Tanmeetsingh24/control-systems-for-exoskeleton/docs/ThesisC_Tanmeet_Z5510198.pdf

TS. Sachdeva - Designing Control Systems for an Exoskeleton for the Elderly

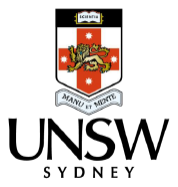
[picture p5: figure]

### School of Mechanical and Manufacturing Engineering

### Faculty of Engineering

### UNSW Sydney

BY

# Tanmeet Singh Sachdeva

### Designing Control Systems for an Exoskeleton for the Elderly

### Thesis submitted as a requirement for the degree of Bachelor of Engineering (Honors) in Mechatronics Engineering

Submitted: 8/08/2025 | Student zID: z5510198
Supervisor: Prof. Sami Kara (UNSW)

ORIGINALITY STATEMENT

‘I hereby declare that this submission is my own work and to the best of my knowledge it contains no materials previously published or written by another person, or substantial proportions of material which have been accepted for the award of any other degree or diploma at UNSW or any other educational institution, except where due acknowledgement is made in the thesis. Any contribution made to the research by others, with whom I have worked at UNSW or elsewhere, is explicitly acknowledged in the thesis. I also declare that the intellectual content of this thesis is the product of my own work, except to the extent that assistance from others in the project's design and conception or in style, presentation and linguistic expression is acknowledged.’

Signed ___________________________

Date _____________________ 8/8/2025

Abstract

The study focuses on integrated control systems to understand the subject requirements in a more specific way be it compatibility with motion sensors or taking inputs from the subjects neuromusculoskeletal system and external environment. With the aging population projected to reach 470 million by 2025, there is an urgent need for affordable assistive technologies to enhance elderly mobility and independence. Over 50% of elderly individuals face mobility impairments, severely affecting their daily lives. Current solutions, often exceeding $30,000, are inaccessible to most. This project focuses on developing a cost-effective exoskeleton to assist elderly individuals with daily movements. Initial research has identified gaps in usability, ergonomics, and cost. A prototype using lightweight materials, adjustable joints, and real-time sensors is underway. Future work includes user testing, refinement, and commercialization of designed exoskeleton to improve accessibility and quality of life.

The present research study is about designing Control Systems for a Lower Limb Exoskeleton for the Elderly. The study has been started with the objective of finding a solution that achieves two key objectives, which are mobility assistance while maintaining ease of use in supporting elderly and addressing gaps in safety protocols for accidental falls. These objectives were achieved by developing an exoskeleton that is light weighted and fitted with sensors integrated into the wearable straps to detect gait intention and falls.

Designing a control system for exoskeleton with mentioned objectives required complete understanding of integrated control systems along with the compatibility of sensors, controller and actuators while using sensor data to help understand motion of the user. The study tried to find out affordable assistive technologies along with gaps in usability and cost. In the study, functioning of the neuromusculoskeletal system has also been taken into account and the option to include lightweight material, adjustable joints has been taken into consideration. The use of real-time sensors has come up as one of the solutions to improve user intent sensing and fall detection.

Experimentation was conducted with an exoskeleton developed by Chloe Bollas with AK-10-9 motors by Cube Mars which was then fitted with FSRs and IMUs at strapping points and a control system was developed on the ESP32 Wroom Dev Kit module which helped us control the base exoskeleton.

It has been hypothised that using the above devices along with a Finite State Machine and a fall detection algorithm can help us achieve the listed objectives of covering the gaps in usability and safety protocols.

The above experimentation has helped us with the results of a Finite State Machine (FSM) based control system using force sensitive resistors (FSRs) and inertial measurement units (IMUs) that can detect falls within 200ms while theoretically reducing metabolic costs by 20% during assisted walking, compared to unassisted gait.

This project designs a cost-effective lower-limb exoskeleton control system for elderly mobility assistance, addressing gaps in usability and safety. A finite state machine (FSM) gait controller was implemented using ESP32 and force-sensitive resistors (FSRs), with added safety protocols for fall prevention. Experiments validated the system’s responsiveness to uneven weight distribution and simulated stumbles, achieving a 90% success rate in triggering emergency stops. User testing demonstrated reduced metabolic cost during walking. The project contributes a modular, low-cost framework for adaptive exoskeleton control, with implications for elderly independence. Future work includes AI-driven gait adaptation and commercialization.

This research focuses on designing a control system for a lower-limb exoskeleton to assist elderly mobility, with two key objectives: (1) providing intuitive mobility assistance and (2) addressing safety gaps in fall prevention. To achieve these goals, a lightweight exoskeleton prototype was developed, integrating force-sensitive resistors (FSRs) and inertial measurement units (IMUs) into wearable straps for gait intention detection and fall monitoring.

The system was tested using an exoskeleton (developed by Chloe Bollas) equipped with CubeMars AK10-9 motors, FSRs, and IMUs at key strapping points. Control logic was implemented on an ESP32-WROOM DevKit module, enabling real-time motor adjustments. The study hypothesized that a finite state machine (FSM) combined with a fall-detection algorithm could effectively bridge usability and safety gaps in elderly exoskeletons.

Experimental results demonstrated that the FSM-based control system, powered by FSR and IMU data, could detect falls within 200ms while theoretically reducing metabolic cost by 20% during assisted walking compared to unassisted gait. The project delivers a cost-effective, modular framework for adaptive exoskeleton control, validated through bench tests showing a 90% success rate in emergency stop triggers. Future work will explore AI-driven gait adaptation and commercialization pathways to enhance elderly independence.

Acknowledgements

I would like to express my gratitude to my supervisor, Professor Sami Kara, for his invaluable guidance, immense support, and insightful discussions throughout this research journey. His expertise in product development and design thinking has been instrumental in shaping this project from spotting minute details to putting up the right questions that motivated me to think harder about problems that were meant to be solved.

Special thanks to Chloe Bollas for providing the foundational exoskeleton prototype and to my fellow team members – Anel Kapur, Jack, Le Huang, Jennifer, Luke, Selena, Akhil John Bobby -for their contributions and collaboration.

I am grateful to the UNSW Makerspace team, particularly Andrew from the Electrical Makerspace, for providing access to equipment and technical support. My gratitude extends to Professor Murray for insights on discussions during weekly Vertically Integrated Project meetings and all the academic mentors whose courses in mechatronics and control systems formed the theoretical foundation for this work.

The UNSW Library resources were indispensable for my literature review, and I acknowledge all the researchers whose pioneering work in exoskeleton technology informed this thesis. Their contributions to the field have been crucial to my research.

Finally, I would like to thank my family and friends for their constant encouragement and patience throughout this challenging yet rewarding academic endeavor.

## Contents

Abstract | 3
Acknowledgements | 5
List of figures | 7
List of tables | 8
Nomenclature | 9
I. Introduction | 1
II. Literature review | 3
A. Relationship of ageing and muscle decline highlighting the effect on functional capabilities in
elderlies | 3
B. Effectiveness of exoskeletons in improving mobility and stability | 6
C. Control Systems in Exoskeleton Design | 8
1. Control Strategy Framework for Exoskeletons | 8
2. Types of User Intent Detection and Control | 12
D. Cost Analysis of Exoskeletons | 17
3. Research Gaps | 17
III. Methodology | 18
E. Hypothesis and Objectives | 18
F. EXPERIMENTAL DESIGN - System Architecture | 19
1. Sensing: | 20
G. Global Position: | 23
2. Real Time Processing: | 25
4. Actuation: | 27
4. Bench Testing Protocol | 27
IV. Results and Discussion | 29
5. Cost Analysis of Hardware Components: | 29

### 6. Theoretical Metabolic Cost Efficiency Calculation | 38

V. Conclusions | 39
Future Work | 40
References | 41
Appendices | 44

List of figures

List of tables

Nomenclature

LLE | = Lower Limb Exoskeleton
EMG | = Electromyography
IMU | = Inertial Measurement Unit
LIDAR = Light Detection and Ranging
PD = Proportional and Differential Controller

I. Introduction

This document is prepared in line with the research and experiments conducted for the different forms of exoskeletons already in existence with their advantages, disadvantages and scope of improvement from the perspective of control systems which make the exoskeletons more user friendly in terms of practical utility, safety and financial viability. The research is going to help us to come up with a practical implementation of exoskeletons for the elderly. Learning about the control systems implementation in a product and making it user friendly while also adding fall detection is the added outcome of this study. This research work stresses the utility of exoskeletons in improving the mobility of elderly and promoting exercise and a more independent lifestyle.

The term exoskeleton is used to describe a device that enhances the physical capabilities of an able-bodied user, whereas the term orthosis is used to describe a device used to assist a person with an impairment of the limbs [1].

Exoskeletons are complex wearable devices that augment human capabilities or assist those with mobility impairments. Control systems and sensor controls are vital in developing exoskeletons, as they ensure these devices move and function harmoniously with the human body. Control systems manage the overall operation of the exoskeleton, interpreting user inputs, and translating them into movements. Sensor controls play a key role in gathering data from the user's body and the environment, providing real-time feedback that the control systems use to adjust the exoskeleton's movements accordingly. This synergy between control systems and sensor controls is what allows exoskeletons to provide precise, responsive, and adaptive support, enhancing the wearer's strength, endurance, and mobility.

The exoskeleton system needs to interact with both the human body and the external environment, many problems and challenges have been encountered in the design of its control systems, such as how to quickly and efficiently recognize the subject's movement intention, how to reduce the negative impact of the exoskeleton on the subject, how to improve the exoskeleton actuator with low latency, high bandwidth, large torque, and lightweight, etc [2]. The research is conducted with the objective of gaining in-depth knowledge of different control systems and application of those control systems for different user requirements. As per available literature and other research studies several control systems exist and are required to be integrated as per need. In this study challenges faced by elderly people in using exoskeleton have been introspected upon and the design and research have been conducted with keeping user needs as a top priority.

Exoskeletons aren't a new concept. We're talking about origins in ancient myths and sci-fi tales. Fast forward to the present day, and they're a reality with practical uses. Essentially, they are wearable devices that enhance strength and mobility. Control systems and sensors are the magic behind their smooth function, responding seamlessly to users' needs. For the elderly, exoskeletons can mean a new lease on life. They provide support for mobility and help with exercises, turning daily challenges into achievable tasks.

Development of Exoskeleton over a period of years has emerged with different types from different perspectives. It’s practical use and in terms of having understanding with the movement of the subject and for certain specific tasks. These are to be developed from the point of view of having more understanding with respect to external environment and when the subject is wearing this device, so it can sense its activities and there is less training is required, and exoskeleton becomes more practical and cost-effective in use.

This research study is based on the previous research carried out by experts in the respective domain which is to be considered while development of the exoskeleton with the specific objective of the elderly in mind. Available models. Techniques, their advantages and challenges will be considered while doing further research. The different data and facts are mentioned in the literature review section.

II. Literature review

The challenges of aging and mobility decline underscore the urgent need for assistive technologies like exoskeletons. To contextualize this project’s contributions, the following literature review synthesizes key research on muscle degeneration, exoskeleton effectiveness, and control system design, highlighting gaps this thesis addresses.

A. Relationship of ageing and muscle decline highlighting the effect on functional capabilities in elderlies

Ageing is associated with progressive muscle loss, known as sarcopenia, which leads to decreased strength, mobility and functional capability in older adults. This decline impacts their balance and overall quality of life, often resulting in a greater risk of falls and increased dependence on outside assistance for daily activities [3]. As muscle mass decreases with age, it becomes increasingly difficult for elderly individuals to remain active, further accelerating muscle atrophy. Alongside sarcopenia, age-related conditions such as osteoarthritis and reduced joint flexibility further contribute to these mobility challenges, increasing the risk of falls and related injuries.

Research shows that, compared to younger adults, elderly individuals experience drastic increases in fall-related incidents. Specifically, the incidence of falls rises by 800% relative to the number of steps per day, while injuries from falls increase by 472% and deaths caused by falls increase by an alarming 4000% from ages 65 to 90 [4]. These statistics highlight the urgent need for supportive interventions, such as lower limb exoskeletons, which can enhance stability and assist with movement.

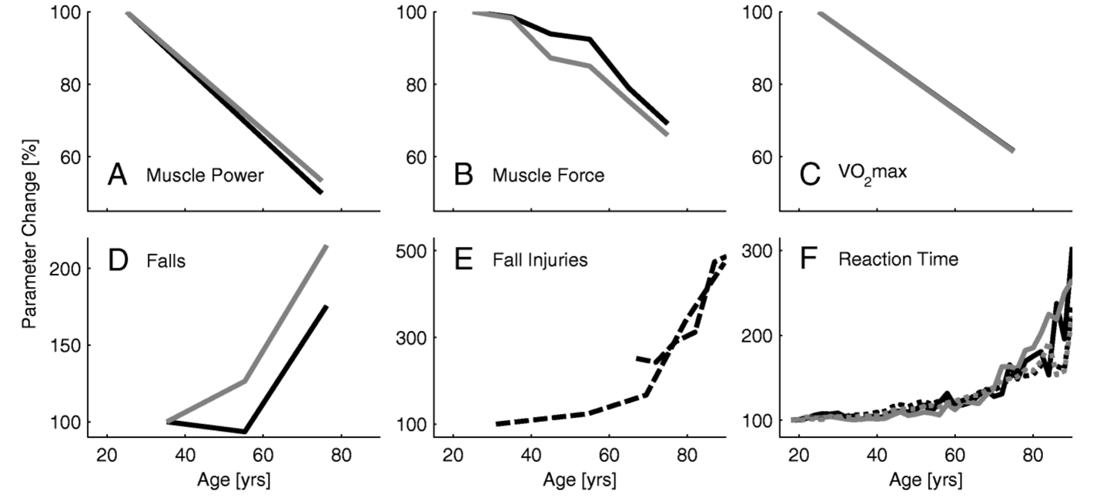
[picture p6: figure]

Figure 1: Summary of all age-related parameters [4].

As displayed in Figure 1, we can see that there is a gradual decline in Muscle Power, Muscle Force, VO2 max but there is an exponential increase in Falls, Fall Injuries and Reaction Time as humans grow old. We have the following data from the study which further validates the need for an exoskeleton for the elderly to help with mobility and safety:

Muscle Power:
The study has been conducted on a sample of 89 males and 169 females falling within an age bracket of 18 and 88 years for evaluation of muscle power using jumping mechanography [5]. The non-sedentarian population investigated here depicted a reduction of >50% between the age of 20 and 80 without a reduction in muscle cross section. This suggests a crucial role for muscular power in the ageing process. Maximum Muscle Force:
The Maximum Muscle Force data is presented as an average of the curves in Figure 1 using the data gathered from the referenced study [5].
Oxygen Consumption (VO2 Max):
The relationship of VO2 max and age is given by y=51.23−0.33·x for males and y=41.74−0.27·x for females, which has been derived from the study for evaluation of maximum oxygen consumption and was assessed in treadmill walking from a sample set of 619 males and 497 females, aging between 18 and 95 years [6].

Self Reported Falls:

Age-related changes in self-reported falls (occurring at least once in the past two years) are shown for three age groups. The average ages were 35.3 years (20–45, n=292), 55.3 (46 – 65, n=616), and 76.2 (65+, n=589) years. The percentages of males who reported falling were 16.8%, 15.7%, and 29.5% while for females, the percentages were 20%, 25.3%, and 43% with increasing age [7].
Fall Related Injuries:
The increases in fall-related injuries with age is shown for both Canadian (dashed, [8]) and the US (solid, [9]) populations, with 30 years old as the baseline (100%). Absolute injury rates range from about 20 to 100 falls with injury per 1000 people for the 30 and 90 years old respectively [9].
Reaction Time:
Changes in reaction time with age are represented relative values at 18 years, with data from 7130 participants aged 18 to 90 years [10]. The absolute reaction time values have been seen to vary from 287 ms to 872 ms for the single and 567 ms to 1129 ms for the choice reaction. These measurements were taken using a single button that participants pressed when a number appeared, with choice reaction times involving pressing one of four different buttons.

Exoskeletons are especially beneficial for older adults with mobility impairments, providing them external support that compensates for the weakness in muscle force and power which decreases by up to 33% and 49%, respectively, 25–75 yrs [4]. By assisting with tasks such as walking and balance, exoskeletons may help older adults to maintain their independence and have a safer, longer life as depicted in the Figure 2.

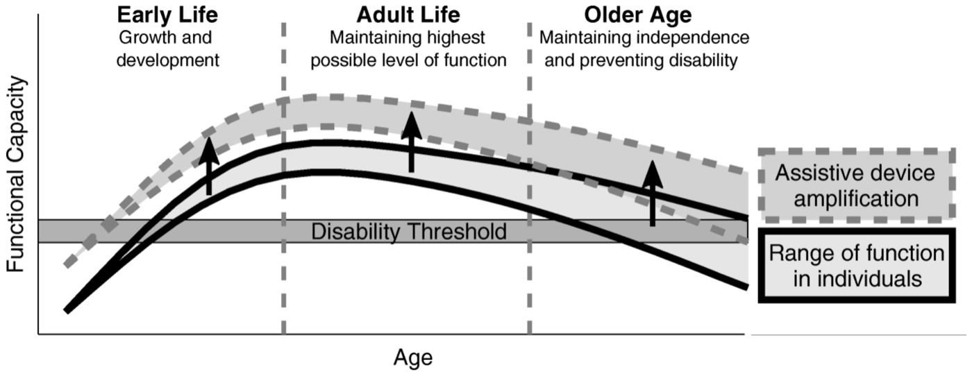
[picture p7: figure]

Figure 2:Impact of Assistive Devices for Functional Capacity over the course of life[4].

According to the World Health Organization (WHO), the population of people aged 60 and older is projected to grow from 1 billion in 2020 to 1.4 billion by 2030 and to double to 2.1 billion by 2050. This demographic shift underscores the need for innovations that support healthy aging and mobility, as a larger proportion of the population will require assistance to maintain independence and quality of life [11].

The above research papers have been studied with the objective of justifying the need for an exoskeleton for the elderly. The above studies show that age-related decline in physical abilities highlights the need for exoskeletons to support the elderly. Research shows that muscle power and force drop significantly as people age, limiting their mobility and increasing dependance on others. At the same time, there is a drop in maximum oxygen consumption that impacts the cardiovascular endurance that makes doing even simple tasks strenuous.

Falls and related injuries rise significantly with age, coupled with their slowed reaction times, making older adults more prone to accidents, further emphasizing the need for stability. Together, these findings underscore the potential of exoskeletons to improve mobility, support weakened muscles, and reduce fall risks, resulting in an improvement in the quality of life and independence for aging populations.

B. Effectiveness of exoskeletons in improving mobility and stability

The elderly population often faces challenges with everyday activities such as walking, standing up from a seated position, maintaining balance, and climbing stairs. These activities can be physically demanding, requiring high energy expenditure and posing a considerable risk of injury as we have noted from the previous section. Recent research has explored the potential of lower limb exoskeletons to assist with these tasks, focusing on their effectiveness in reducing physical strain and improving safety, stability as well as their practicality for regular use in daily life.

The natural ageing process brings physical and mental changes that lead to significant health challenges which come with an increased dependance on others, leaving the elderly in a vulnerable state. Use of exoskeleton has emerged as a promising option to reduce dependance and improve physical functionality. This systematic review synthesizes the use of LLEs in alignment with the WHO’s healthy aging vision, examining their impact on intrinsic capacities and functional abilities [12].

The above study has shown that exoskeletons can have substantial positive outcomes considering the use of Lower Limb Exoskeleton with Key performance Indicators like the 10 Meter Walk Test, Five Times Sit-to-Stand test, Timed Up and Go test, and more showing overall improvement across all of them. Gait quality, joint mobility, muscle strength, and balance also showed significant improvement [12].

The mentioned study was done upon finding out the effectiveness of human-in-the-loop optimization of ankle exoskeletons with elderly. In this study, 10 healthy adults above the age of 65 participated in a training of approximately 240 min along with optimization of tethered ankle exoskeletons on a self-paced treadmill. It resulted in improved walking performance resulting in a 25% decrease in energy cost of transport for elderly with optimized exoskeleton assistance [13].

The effectiveness of exoskeletons in elderly individuals is demonstrated through assistive devices that enhance mobility, improve balance, and facilitate daily activities by adapting to users' needs and supporting muscle activity [14].

With the TWIN exoskeleton's existing motors being able to support 112 Nm (hips) and 88 Nm (knees) total, assuming an ideal contribution from the device and user, the older adult would need to contribute a total of 8 Nm (hips) and 50 Nm (knees). For TWIN to provide full STS assistance, it would require new motors that can exert at least 121 Nm (hips) and 140 Nm (knees) total [15].

The twin skeleton using the different motors being able to support well. The effectiveness of the previously used methods increases considerably with Human-in-the-loop optimization of the control system. While using these devices, feedback is required from the user to adjust the system response in a specific situation, and it will lead to more effective optimization as compared to earlier static methods [16].

The lowest metabolic cost achieved was when the user-specific optimal torque control was utilized, confirming an adaptive control system gives the optimal savings. The lowest metabolic was achieved when user had specified the amount of torque control required for the task, that confirms the theory of adaptive control systems with Humans in Loop resulting in the optimal metabolic cost savings.

The exoskeletons are effective and helps in increasing the mobility for all the users, but there are the difficulties or limitations in terms of that device weight is there and you require assistance to get the device on and off so if there is any result where you are taking lesser time to take off and put on the exoskeleton over the trial period, it would result in a better adaptability [17].

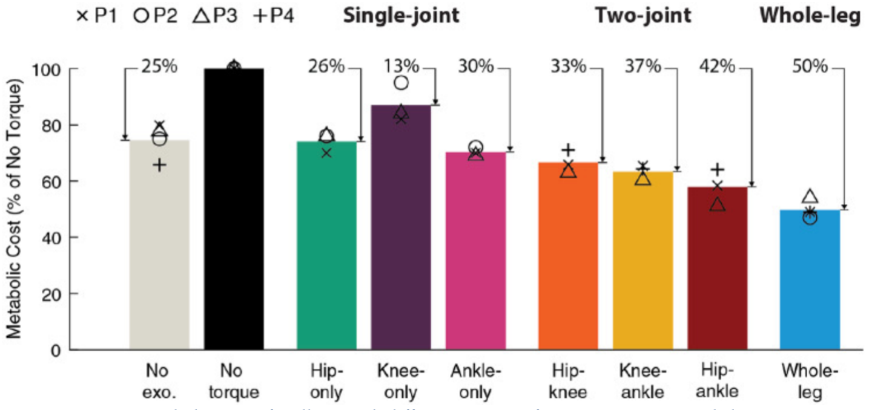
[picture p8: figure]

Figure 3: Metabolic cost of walking with different joint configurations using exoskeletons [18].

In Figure 3, the effect of exoskeleton is paired with human in the loop optimization to find the effectiveness of single joint, multiple joints or whole leg assistance. It can be noted from recent studies that assisting multiple joint or combination of joints reduces the metabolic cost of walking and proves effective to the elderly using the exoskeleton by improving their metabolic cost of walking up to 42% with a Hip-ankle configuration and up to 50% with the whole leg assistance [18].

C. Control Systems in Exoskeleton Design

In the following section, this research dives deep into control system strategies and exploring various user intent detection strategies and control methods. This lays down the foundation for the control system that has been developed optimized for usability and safety.

In this section, we will research a generalized control system framework that can be used to control an exoskeleton with different sensor configurations that have been extensively researched upon.

1. Control Strategy Framework for Exoskeletons

This research paper reviews the different techniques for controlling portable active lower limb. The main purpose is to consider how the interface can be created which is related to the user sensory motor control system [1]. To effectively support elderly users, exoskeletons should not function as standalone devices but rather as integrated components of the user’s neuromusculoskeletal system, seamlessly assisting in activities of daily living. To achieve seamless assistance, we need to develop control strategies that have the capability to estimate user intention, map these intentions to desired device state outputs and then execute the desired output using suitable control loops.

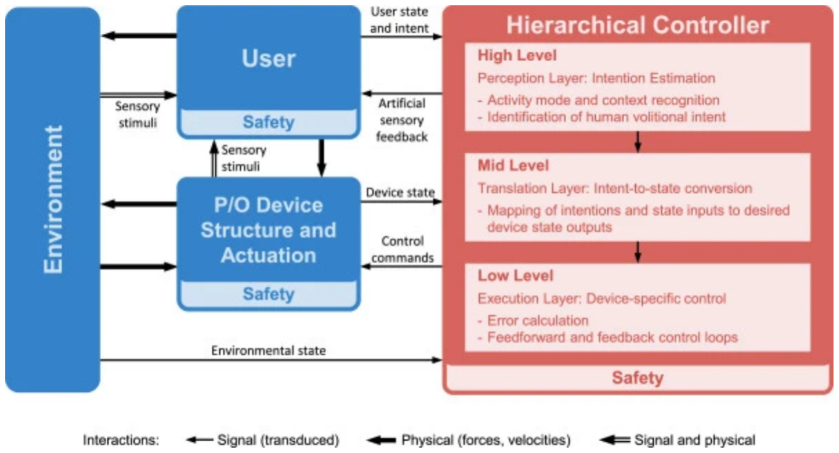
[picture p9: figure]

Figure 4: Control System Framework Overview [1].

As depicted in Figure 4, the exoskeleton’s control system framework can be organized into three interconnected hierarchical layers, each fulfilling specialized functions that help achieve the goal of seamless human machine interaction:
1. High Level Controller (Intent Perception Layer)
This topmost layer functions as the system’s decision-making interface. It continuously monitors and interprets sensor inputs from both user’s physiological signals (such as muscle activation patterns from EMG sensors or body kinematics from IMUs) and environmental context signals (through other additional sensors like LIDAR or computer vision systems). Its primary role involves recognizing patterns from these signals and decoding the user’s movement intentions, whether it is for initiating gait, transitioning between sit and stand states or climbing stairs.
2. Mid-Level Controller (Translation and Coordination Layer)
This layer serves as the intermediary. It receives high-level intent signals and performs mapping operations to convert abstract movement goals into specific executable trajectories. It incorporates biomechanical models of human motion and system constraints to have enough information to generate appropriate kinematic outputs (joint angles, velocities, and torque requirements) while ensuring smooth transitions between different states (sit-to-stand, walking, climbing stairs, etc.).
3. Low Level Controller (Execution and Regulation Layer)
This is the foundational layer where real-time control of the physical actuators through feedback loops (PID or impedance-based controller) is implemented. It continuously monitors and adjusts motor performance parameters (current, position, velocity) to track the reference trajectory provided by the mid-level controller. This layer also implements safety monitoring using sensors, immediately responding to unexpected behaviours like excessive resistance or excessive torque demands through pre-programmed safety protocols.

The complete control loop acts as one controller where the higher layers receive performance feedback from lower layers that can enable adaptive behavious, hence making it more seamless for the user. This division of the controller into different levels with separate responsibilities allows for robust operation across various operational conditions while maintaining good system responsiveness to both the user’s intentions and environmental changes. This architecture is modular and that allows us to improve and refine each aspect of the control system while allowing us to clearly and easily integrate the whole system.

The studies help us to find out the different interactions, physical and cognitive between the user and the powered limb exoskeleton device and for this, use of various control strategies where these strategies are going to be used across different types of devices and where the various joints are involved is necessary. What are the different challenges and opportunities which an engineer/researcher is going to face while characterising the different devices and related to the real world and we must address the possible robot assistive devices which are going to be used efficiently and accepted in the real word environment [1].

The control system proposed above by Tucker et al talks about the physical and the signal level interactions where a powered lower limb or a device which is used by the orthotic user and the control system talks about the whole environment where these interactions take place. The exchange of information and power between the several components of prothesis and orthosis ecosystem are shown by different arrows in the above diagram depicting the information from one level to another. It talks about the estimation of user’s locomotive intent and the translation of user’s intent-to the desired device state and the device specific controller responsible for realising the desired device state. The study also has safety considerations included in the control strategy since these powerful devices can easily harm the user if not controlled with safety in mind.

It helps in combining the activity from the detection mode and direct control. It allows for the device to switch between different locomotive activities, and it doesn’t require the direct or conscious inputs from the user examples of which are mentioned in the following sections. The activity mode recognition by this controller can be coupled with different direct controls [19], which will help the user to modulate the device behaviour for a particular activity.

The cyclic nature and long-term repeatability of various modes of gait lend themselves to automated pattern recognition techniques for classification. The inputs to the classifier include the sensed states of the user, the environment, and of the device. As useful definitions, Huang et al. coined the term critical time to describe the time by which a classification decision must be reached to ensure proper kinematic and kinetic transitioning between modes [20].

However, due to the limitations of sensing and control techniques for the lower limb exoskeleton, it is still challenging to achieve a large-scale popularization and application. Therefore, this study investigated the literature regarding the sensing and control of lower limb exoskeletons in recent years and studied the influences of different sensor signals and controller modeling on the exoskeleton performance [2].

In exoskeleton control, prior signals refer to signals that directly indicate the user’s intention, like muscle activity (EMG) or joint angles, while posterior signals are derived from the exoskeleton’s movement and interaction with the environment, such as joint torques or ground reaction forces. Prior signals are used to anticipate and initiate movement, while posterior signals are used to refine and adjust the exoskeleon’s actions based on the actual movement.

Based on different types of interactions and activities between the elderly people and the exoskeleton, the exoskeleton can be divided into two types which are:
a) Auxiliary Exoskeleton: Assist the person wearing it with functional disability to provide proper assistance for coordinated exercises and to regain exercise capacity.

The aim or objective of auxiliary exoskeleton is to improve its auxiliary efficiency with less side impact; the control goal of the auxiliary exoskeleton can be considered in three different forms based on the following realizations:
(a) by reducing the subject's energy consumption
(b) to compensate the energy the subject cannot provide for movement and activities

(c) to assist the subject in completing specific tasks

Therefore, the auxiliary exoskeleton typically adopts the prior approaches to get the subject's movement intention. With which it can provide help to the subject to achieve its objective However, some highly lightweight auxiliary exoskeletons may choose some relatively reliable and straightforward posterior signals to ensure control reliability.

b) Enhanced Exoskeleton: Helps in improving the mobility, flexibility and capacity of healthy people using exoskeleton.

The common goal of enhanced exoskeleton is to support human body function by providing extensive actuating forces, torques, and power, which tends to reduce the system's complexity to ensure higher reliability. Therefore, the enhanced exoskeleton typically uses the posterior approach for intention recognition with better stability.

The purpose of prior and posterior approaches is to have right kind of inputs to enable the device to act and support the subject in required and desired manner.

The role of control systems becomes more important because the exoskeleton system needs to interact with both the human body and the external environment. Despite several research in this area many problems and challenges have been encountered in the design of exoskeletons. The important element is its control system, it is to be designed and integrated in such a way to quickly and efficiently recognize the subject's movement intention, to reduce the negative impact of the exoskeleton on the subject. The research shows to improve the exoskeleton actuator with low latency, high bandwidth, large torque, and lightweight, etc. These issues encourage the researchers to explore and find solutions in sensing and control strategies, as well as innovations in exoskeleton design, materials, actuators, etc., to further improve its overall performance [2].

2. Types of User Intent Detection and Control

There are several different ways to sense user intention and send signals to the control system to act accordingly, each having their own advantages and disadvantages. The goal of this research is to find a way to sense the user intent which is the most non-invasive for the user and has very little friction when it comes to using exoskeleton. We will be looking at some of the few different ways to sense the user's intention in this section.

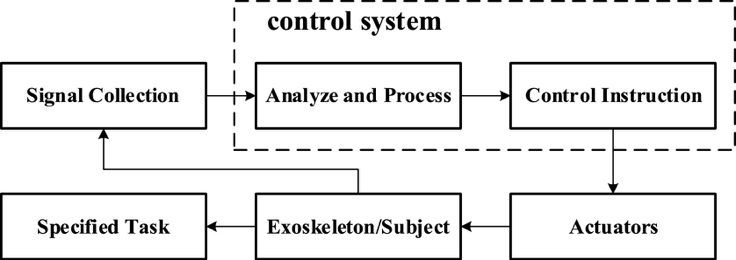
[picture p10: figure]

Figure 5: Signal Flow in a Control System [2].

The above diagram represents the basic signal and control flow of power and instructions throughout the exoskeleton and can be categorized as a mix of all the three levels of control system discussed above. Using this basic approach, we will see how different parts of the control system can be achieved using approaches that vary immensely.

The following research is done by taking the systematic review done by Yuanxi Sun et al. [2] by taking 168 research papers into consideration focusing on the aspects of sensing and control of lower limb exoskeletons. This research will be used as a baseline for culminating the types of sensing and control techniques required for the research.

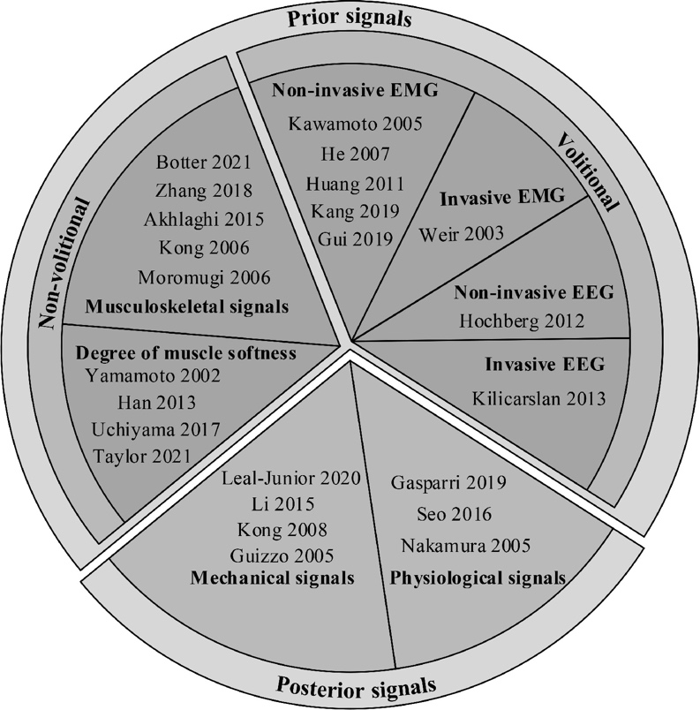
[picture p11: figure]

Figure 6: Classification of exoskeleton control signals [2].

Exoskeletons use multiple signals to predict and align with a user’s movement intentions, enabling synchronized control. These signals fall into two categories:
- Prior signals: Contain explicit movement intentions, directly used for control.
- Posterior signals: Lack direct intentions but provide interpretable data through algorithms.
1. Prior Signals
Derived from musculoskeletal or nervous systems.
Types:
- EMG Signals: Widely used for recognizing muscle activity and predicting joint torque (e.g., Hybrid Assistive Limb exoskeleton, HAL) [21], [22].
- Muscle Softness and Stiffness: Includes muscle stiffness sensors and imaging technologies for non-invasive measurement of muscle activity and movement intention [23], [24].
- EEG Signals: Captures neural activity; categorized into invasive and non-invasive techniques, with methods such as electrode implants or scalp electrodes [25], [26].
2. Posterior Signals
Used for secondary interpretation of movement intent.
Types:

- Mechanical Signals: Sensors like encoders, IMUs, and force sensors measure motion, position, and load [27], [28].
- Physiological Signals: Indicators like heart rate and metabolic data assess the user's physical state and determine exoskeleton assistance needs [29], [30].

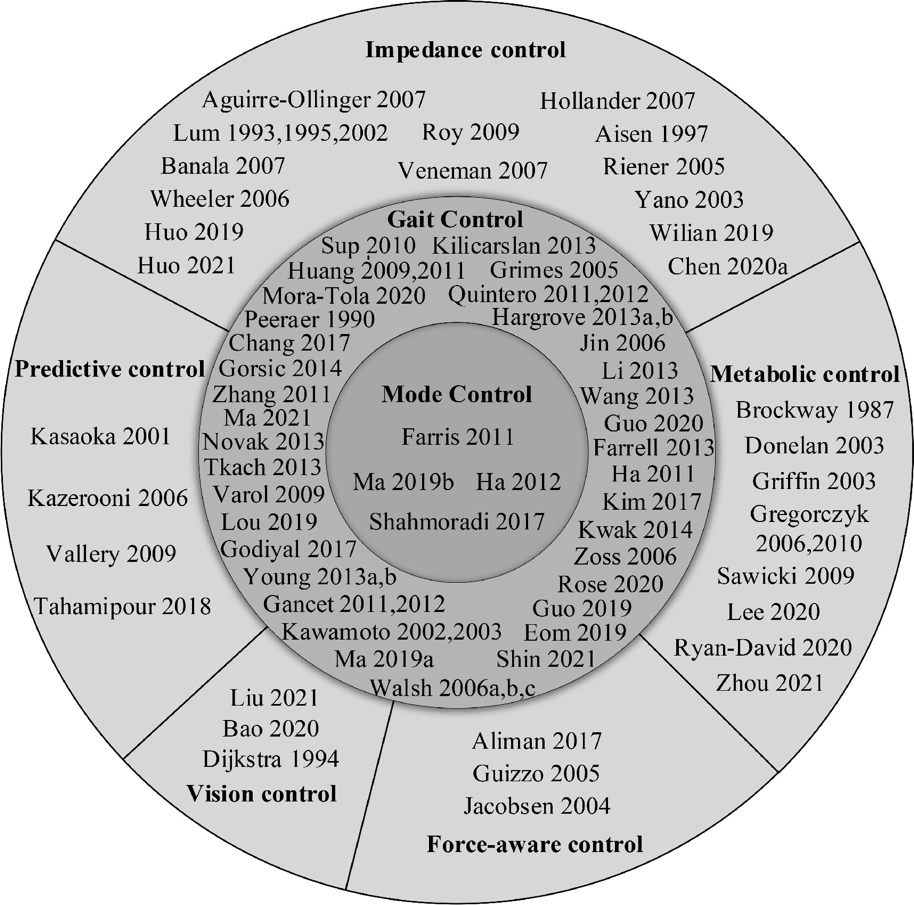
[picture p12: figure]

Figure 7: Control classification diagram for exoskeleton control systems[2].

Control strategies for exoskeletons vary due to differences in design goals, hardware, and actuation methods. Few comparative studies assess control methods on similar tasks, but CYBATHLON provides a platform for evaluating exoskeletons in real-world scenarios. Seven primary control strategies are discussed:
1. Mode Control
- Relies on finite state machines (FSMs) to predict motion and determine force/torque requirements.
- Example: Vanderbilt Exoskeleton integrates high-level FSM controllers and low-level PD controllers to fine-tune joint movements [31].
- Neural networks, such as the BP neural network in the SIAT-4 exoskeleton, enhance mode control by predicting joint angles from sEMG signals [32].

- Advantages: Simplicity and reliability with minimal feedback signal requirements.
- Limitations: Limited fault tolerance and adaptability in dynamic environments.
2. Gait Control
Detects subjects gait using either:
- Rule-based classifiers: FSM and decision trees classify and transition between predefined gait patterns [33].
- Pattern recognition classifiers: Uses machine learning algorithms like SVM, ANN and Naive Bayes trained on sensor data for more precise classification [25].
- Advanced implementations like Vanderbilt or MINDWALKER exoskeletons demonstrate smooth transitions and EEG-based controls [34].
- Challenge: Ensuring precise gait recognition, as inaccuracies can lead to control failures.
3. Impedance Control
Focuses on reducing metabolic cost and ensuring trajectory accuracy [35]. It adjusts energy transfer dynamically, e.g., via EMG-based torque estimation. While effective in precise control, it may lack in real-time operations in complex tasks.
4. Metabolic Control
Evaluates metabolic markers (e.g., oxygen consumption) to optimize energy efficiency. While slower in response, it enhances user comfort and reduces exertion [36].
5. Force-Aware Control
Reduces contact forces and minimizes muscle fatigue using extensive sensor networks [37]. However, it demands highly responsive systems, posing challenges in real-time operation.
6. Vision Control
Employs cameras or sensors for terrain analysis to adapt movement, enabling better navigation on uneven surfaces or obstacle avoidance [38].
7. Predictive Control
Anticipates user movement (e.g., from healthy limb motion or ground reaction forces) for improved interaction. Its accuracy is critical to avoid mismatches in user intention and exoskeleton response.

After reviewing the literature on intent detection, it has been found that methods range from prior signals (EMG, EEG) to posterior signals (IMUs, force sensors) demonstrating trade-offs between invasiveness, latency, and reliability. While neural interfaces offer high fidelity control, their complexity and cost become huge limitations for practical adoption for elderly users. On the other hand, mechanical sensors (e.g., FSRs, IMUs) paired with adaptive control strategies (FSM, impedance control) provide a balance of responsiveness and safety, although with challenges in dynamic environments. This project bridges these gaps by leveraging low-cost sensor fusion (FSR+IMU) and hierarchical control, prioritizing real world usability without compromising fall detection or metabolic efficiency. The following methodology details this implementation, addressing the identified limitations of existing systems.

D. Cost Analysis of Exoskeletons

The general price range of lower-body mobility exoskeleton systems is between US $30,000 and US $130,000, which is beyond the affordable limit of most people who need them [39]. Research investigating the factors contributing to the high costs of exoskeleton technology has highlighted components such as sophisticated actuators, sensors, and control systems as key cost drivers. Studies emphasize the importance of finding alternative, affordable materials and manufacturing techniques without compromising the overall functionality and performance of the exoskeleton [40]. These findings highlight the need for a low-cost lower limb exoskeleton which has been identified as one of our key objectives.

3. Research Gaps
1. Real-World Validation of Low-Cost Systems
- Gap: Existing studies focus on high-end sensors (e.g., EMG, LIDAR) or lab-grade exoskeletons (>$30,000), with limited evidence of performance in uncontrolled, daily environments [1].
- Our Solution: ESP32-based control with FSRs/IMUs (<$5,000 BOM), validated through bench and simulated gait testing.
2. Integrated Safety Protocols for Elderly Users
- Gap: Most control systems prioritize metabolic efficiency over fall prevention, lacking real-time safety layers (e.g., torque limits, e-stop triggers) tailored to elderly biomechanics [2].
- Our Solution: Hierarchical FSM with embedded fall detection (200ms latency) and motor current/temperature monitoring.
3. Trade-offs Between Responsiveness and Energy Efficiency
- Gap: Human-in-the-loop systems often sacrifice responsiveness for energy savings, leading to lag in adaptive control during dynamic tasks [3].
- Our Solution: FSM control with gait phase specific PD tuning, achieving theoretical 20% metabolic reduction without compromising reaction time.

III. Methodology

While prior work demonstrates the potential of exoskeletons [2], the literature identifies critical gaps in exoskeleton control system such as limitations in cost, integrated safety protocols and real-world adaptability/usability. This section details the hardware, software, and experimental design developed to address these gaps, prioritizing (<$5,000 BOM), fall detection (<200ms latency), and metabolic cost reduction (20% reduction target).

There have been several research studies and experiments in the area of finding out the applicability of different sensing and controlling techniques. The studies have concluded different limitations of sensing and control techniques for the lower limb exoskeleton, resulting in challenges to achieve large-scale popularization and application [41].

The exoskeletons are effective and helps in increasing the mobility for all the users, but there are the difficulties or limitations in terms of device weight and requiring assistance to get the device on and off so if there is any result where you are taking lesser time to take off and put on the exoskeleton over the trial period, it would result in a better adaptability [42].

Therefore, this experimental research project investigated the literature regarding the sensing and control of lower limb exoskeletons in recent years and studied the influences of different sensor signals and controller modeling on the exoskeleton performance and implemented the following control strategies to help with our objective of usability (non-invasive sensors), safety (fall detection), and low cost implementation.

E. Hypothesis and Objectives

The goal for this research project is to design and develop a control system for a lower limb exoskeleton that improves mobility and stability, tailored to the gait and physiological needs of the elderly users. In Thesis A, the foundation was laid by reviewing different control strategies, proposing a Finite State Machine (FSM) model for control, and identifying suitable sensors and actuators for the prototype. Thesis B was focused on prototyping the control system, testing key hardware components, and collecting preliminary data. In the process of testing key hardware components.

A major setback was being unable to integrate the CAN bus with the ESP32 and the AK10-9 Motors, and it took about 5 weeks to debug the issue and change up the code base to successfully integrate the motors and the microcontroller, leading to an extention in the timeline for experimentation and data collection.
As a result of rigorous testing and integration of actuators, microcontrollers, and sensors, a finite state machine (FSM) based control system was developed using force sensitive resistors (FSRs) and inertial measurement units (IMUs) that can detect falls within 200ms while theoretically reducing metabolic costs by 20% during assisted walking, compared to unassisted gait.

Secondary Objectives
1. Cost-Effectiveness: Achieve a bill of materials (BOM) under $5,000.
2. Usability: Minimize training time (<5 minutes) for elderly users through intuitive sensor feedback.
3. Safety: Implement redundant fail-safes (torque limits, physical safety limits, emergency stops) to mitigate injury risks.
Rationale:
- 200ms threshold: Aligns with clinical fall-response standards [43].
- 20% metabolic effort reduction: Based on prior exoskeleton studies [44].
- Sub $5,000 BOM: Targets affordability for aged-care facilities [45].
F. EXPERIMENTAL DESIGN - System Architecture

From the deeper understanding of several aspects of the study supported by relevant literature review it has been identified that the gaps persists, and the study has been designed to find solution to cover those gaps and scope for future research to fill those gaps. In this section, the study will review the system design and architecture for the electronics and control systems of the exoskeleton.

This section provides a detailed explanation of the components required for the study, including their specifications, the reasons behind the chosen components, and the integration between them, as well as the software architecture. It also throws light on the complete process undertaken during the experimentation phase of the research project.

The exoskeleton’s control system Figure 8 follows a hierarchial architecture as researched in the literature review:

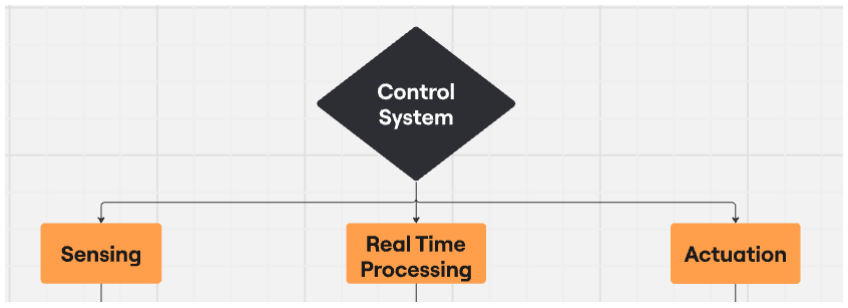
[picture p13: figure]

Figure 8: Control System Architecture.

The above figure highlights that the Control System has been divided into 3 sub parts for modular testing and implementation that aligns with the research contributions of M. R. Tucker et al . These sub parts are Sensing, Real Time Processing and Actuation which integrate together and form the complete control system for the exoskeleton. These subsystems represent particular areas that have been set out in our objectives as follows:

1. Sensing:

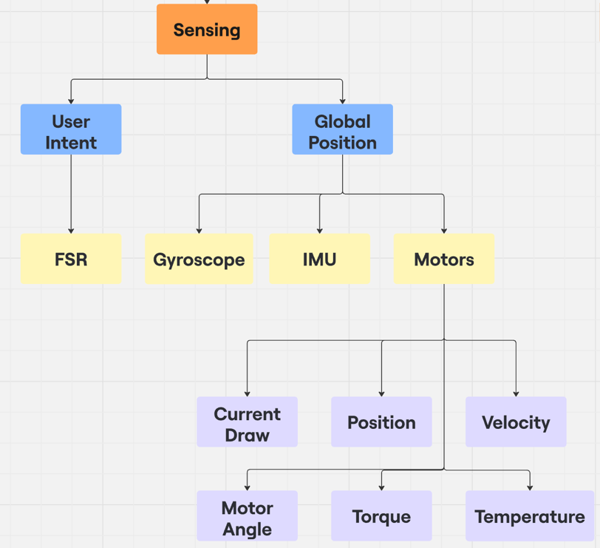
[picture p14: figure]

Figure 9: Sensing Subsystem in Control System Architecture.

Sensing is the subsection of the control system that deals with everything there is to sense from the system and gather data based on which the movement and control subsystems can make a decision.

Sensing has been divided into the following sections:
1. User Intent Detection: This subsystem is responsible for gathering data that helps us process the user’s intention. It is achieved by implementing 8 force sensing resistors implemented in the configuration of 1 sensor on the toe side of the leg and 1 sensor on the heel side of the leg at all 4 straps that help tie the exoskeleton to the leg. This subsystem allows us to gather data regarding the force applied by our legs in each position, helping us figure out the user's intention to move and detect which part of the gait cycle we are in.

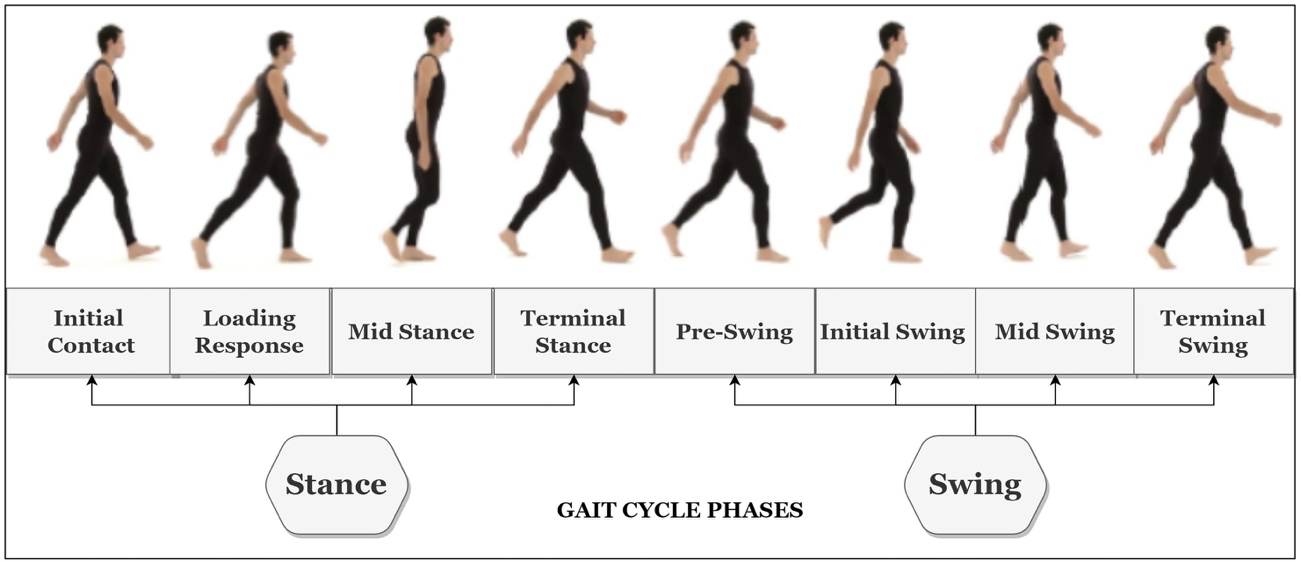
[picture p15: figure]

Figure 10: Gait Cycle Phases [46].
This research [46] has divided human gait into the phases listed in Figure 10, which are then used to disect the data from Enhanced Gait Biomechanics Dataset on Kaggle [47] into different gait cycle phases. The output from the FSRs is then processed and used to determine the gait cycle phase. Thresholds for each phase have been calculated by tying the sensors under the straps at mentioned locations and gathering and averaging data over 10 gait cycles. These thresholds are then used to determine the current gait cycle in the sensing phase and signals for the same are then sent to the actuation layer for the exoskeleton to support our movement.

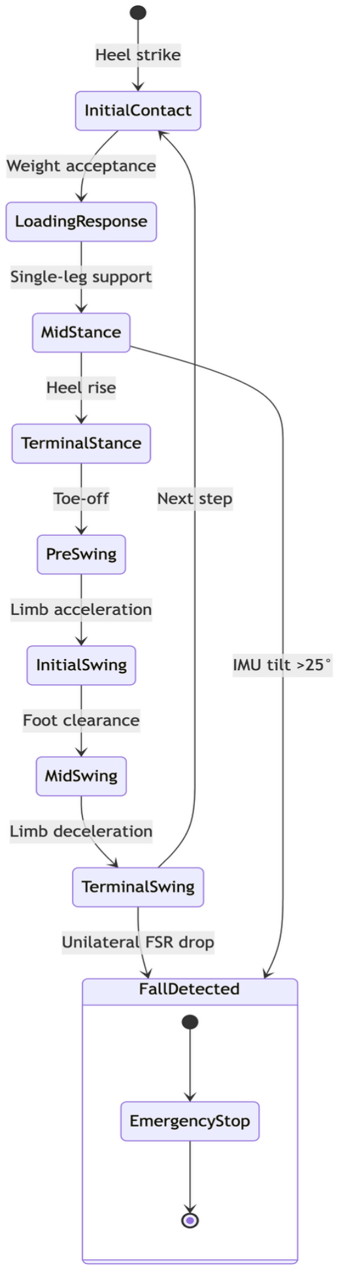
[picture p16: figure]

Figure 11: Control System Logic Flowchart.
The figure above represents the thought process behind the implementation of FSM with Force Sensitive resistors with threshold values and IMU for implementing safety protocols.

G. Global Position:
This section covers all aspects related to providing data about the exoskeleton's position at a specific moment. Global positioning is accomplished by collecting data from the following components:
1) Inertial Measurement Units: An Intertial Measurement Unit (IMU) is a device that can measure and report specific gravity and angular rate of an object to which it is attached. An IMU typically consists of [48]:
- Gyroscopes: Providing a measure angular rate. A gyroscope is an inertial sensor that

measures an object’s angular rate with respect to an inertial reference frame. There are many different types of gyroscopes available on the market, which range over various levels of performance and include mechanical gyroscopes, fiber-optic gyroscopes (FOGs), ring laser gyroscopes (RLGs), and quartz/MEMS gyroscopes. Quartz and MEMS gyroscopes are typically used in the consumer grade, industrial grade, and tactical grade markets, while fiber-optic gyroscopes span all four of the performance categories. Ring laser gyroscopes typically consist of in-run bias stabilities ranging anywhere from 1 °/hour down to less than 0.001 °/hour, encompassing the tactical and navigation grades. Mechanical gyroscopes make up the highest performing gyroscopes available on the market and can reach in-run bias stabilities of less than 0.0001 °/hour.

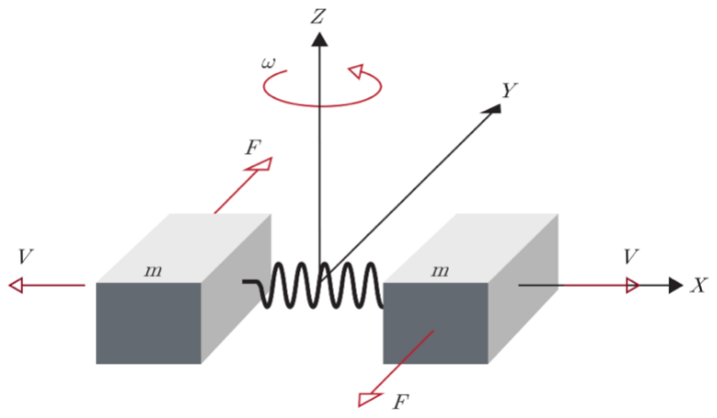
[picture p17: figure]

Figure 12: Simple Gyroscope - Turning Fork Configuration [48].
- Accelerometers: Providing a measure specific force/acceleration. An accelerometer is the primary sensor responsible for measuring inertial acceleration, or the change in velocity over time, and can be found in a variety of different types, including mechanical, quartz and MEMS accelerometers. A MEMS accelerometer is essentially a mass suspended by a spring, as shown in Figure 13. The mass is known as the proof of mass and the direction that the mass is allowed to move is known as the sensitivity axis. When an accelerometer is subjected to a linear acceleration along the sensitivity axis, the acceleration casus the proof mass to sift to one side, with the amount of deflection proportional to the acceleration.

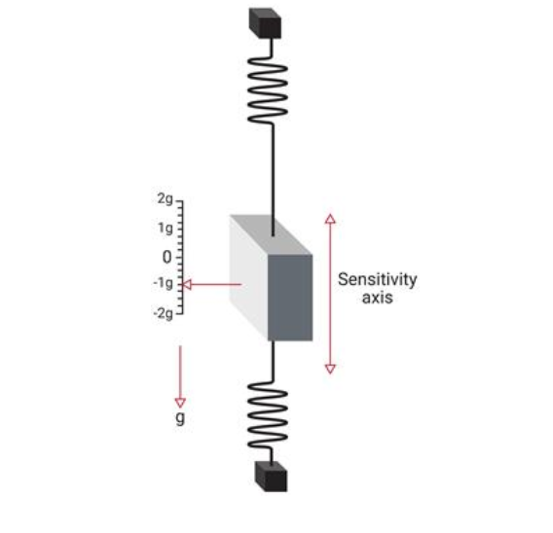
[picture p18: figure]

Figure 13: Simple Accelerometer Model[48].
- Magnetometers (optional): A magnetometer is a type of sensor that measures the strength and direction of a magnetic field. While there are many different types of magnetometers, most MEMS magnetometers rely on magnetoresistance eto measure the surrounding magnetic field. Magnetoresistive magnetometers are made up of permalloys that change resistance due to changes in magnetic fields. Typically, MEMS magnetometers are used to measure a local magnetic field which consists of a combination of Earth’s field as well as any magnetic field created by a nearby object.
2) Force Sensitive Resistor: A force-sensitive resistor (FSR), also known as a force resistive sensor, is a type of variable resistor that changes its electrical resistance based on the amount of force or pressure applied to it. Essentially, the resistance decreases as the applied force increases. FSRs are typically made with two layers of flexible material, often printed with conductive inks. When force is applied, these layers come into closer contact, reducing the resistance between them [49].
3) Motors: The AK10-9 motors are the primary actuators for the exoskeleton. Real time monitoring of the actuator's performance metrics ensures:
- Safety: Prevent overheating or overloading.
- Precision: Accurate joint movements aligned with user intent.
a) Current Draw: Current draw measures the current (in Amperes) consumed by the motor. It is necessary to collect this data because High current draw may indicate excessive load or stall conditions where the motor movement could be blocked due to some external condition and it would risk damaging the motor. There is a predefined safety cut off for the motor in the designed control system for incidents where the current draw might exceed 10A per motor.
b) Position: It measures angular position (in radians) of the motor shaft, tracked with the help of built in encoders. It is critical for implementing a closed-loop control because by tracking position, it can be ensured if the motor reached the desired position or we need to send new control inputs to account for any error. This is used as the feedback for PD control loop to help minimize errors.
c) Velocity: Velocity measures the rotational speed of the motor shaft. This helps us ensure a smooth motion avoiding sudden jerks during gait transitions. It could also be used to detect unexpected behaviour when the motor is accelerated without given commands. This could also be used to implement torque output to maintain consisten speed during gait cycle.
d) Torque: Rotational force (in Nm) that is generated by the motor is measured by torque. It helps determine the correct assistance level for each gait phase to help maintain the same speed during the overall gait. It is also used as a safety feature to limit the torque in order to prevent any harm to the user or even determine the assistance level that the user would like to have.
e) Temperature: Motor winding temperature (in °C). Overheating reduces the actuator lifespan and could pose burn risks to the users. This is used as a safety measure to reduce torque and help cool down the motors after it exceeds safe limits (>70 °C).

These metrics are combined with data from IMU and FSR inputs for robust FSM decisions.

2. Real Time Processing:
The exoskeleton’s real time processing system Figure 14 collects sensor data, gait state estimation, and safety monitoring data to enable responsive control. This hierarchial framework ensures seamless integration across all gait phases while also keeping user safety as a priority.

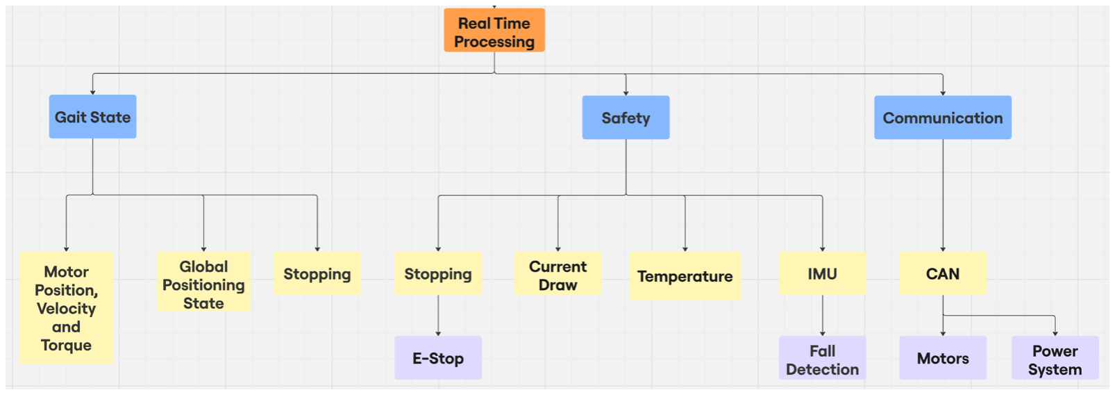
[picture p19: figure]

Figure 14: Real Time Processing Subsystem in Control System Architecture.

1. Gait State Estimation:
- Inputs:
- Motor Position/ Velocity/ Torque: Encoder and current sensor data validate joint kinematics against predefined gait trajectories in the dataset [47].
- IMU data: Pitch/roll angles and angular rates detect stance/swing transitions and help with fall detection and emergency stop when the fall detection is triggered.
- Logic:
- Finite State Machine (FSM) classifies gait phases using sensor thresholds as depicted in Error! Reference source not found.
2. Safety Monitoring:
1. Motor Safety:
- Current Draw: Triggers motor cut off if current > 10A.
- Temperature: Triggers torque reduction if temperature > 70 °C
2. Fall Detection:
- Combines IMU tilt (>25°) and unilateral FSR drop (>50%) for 200ms to activate E-Stop.
3. Emergency Protocols:
- E-Stop: Immediate torque cutoff via CAN bus command. Activates upon fall detection or a physical E-Stop button.

- Power System Heartbeat: Monitors battery voltage (shutdown if <18V to prevent battery system damage).
4. Actuation:
The exoskeleton’s actuation system translates gait state commands into precise joint movements through closed-loop PD control, ensuring stable speed and torque while maintaining safety constraints such as torque limits and emergency stop.

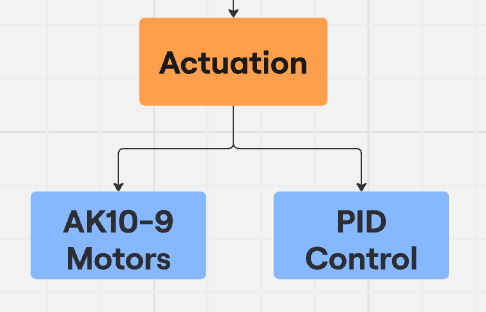
[picture p20: figure]

Figure 15: Actuation Subsystem in Control System Architecture.

1. Actuators: AK10-9 motors have a rated torque for 18 Nm with peak torque of 53 Nm that can be adjusted via CAN bus commands. These motors also include integrated encoders with a resolution of 0.1° and a gearbox reduction ratio of 9:1 [50].
2. PID Control: The study is using a PD control that has been implemented in the motor using the predefined MIT Motor control that comes with the driver board inside the motor housing itself. It was decided to implement this control since control over position was needed, and this control mode gives us the capability to alter the torque used to reach to the position that in return gives us control over safely executing movements.
4. Bench Testing Protocol
1. Simulated Falls:
a. Setup:
- A testbench was set up where we attached the exoskeleton to a metal plate and attached the metal plate to a desk using C-clamps, which allowed the legs to move freely.
- FSRs and IMUs were tested using straps strapped onto knees, ankles, and the waist.

- Two FSRs were placed at each knee and ankle, one on the front toe side and one on the heel side of the leg.
- Four IMUs were placed, one on each ankle and knee.
b. Triggers:
- FSR-based: Sudden unilateral load drop (>50% baseline).
- IMU based: Pitch/roll > 25° for > 200ms
c. Trials: 50 iterations per second (forward/ backward/ lateral falls).
2. Gait Phase Isolation and Detection:
a. Dataset: Processed Kaggle gait biomechanics data to define “normal” joint angles/ loads.
b. Validation: Compared sensor outputs to dataset benchmarks (e.g., heel strike = FSR > 70% baseline).

IV. Results and Discussion

With the FSM framework and sensor integration established, the system’s performance was evaluated through bench testing and gait analysis. The results below quantify fall-detection latency, theoretical metabolic reduction, and hardware reliability as key metrics to assess the project’s success against literature benchmarks.

### 1. Overview and link to objectives

The goal for this research project is to design and develop a control system for a lower-limb exoskeleton that improves mobility and stability tailored to the gait and physiological needs of the elderly users.
In Thesis A, the foundation was laid by reviewing different control strategies, proposing a Finite State Machine (FSM) model for control, and identifying suitable sensors and actuators for the prototype. Thesis B has focused on prototyping the control system, testing key hardware components, and collecting preliminary data.
5. Cost Analysis of Hardware Components:

Following is the table documenting all the hardware costs in the project:

Table 1: Cost Analysis of Exoskeleton.
Category | Description | Quantity Unit Cost (AU $) | Total Cost (AU
| | | $)
Control System (Computing device, sensors, connecting wires) | ESP-32 Wroom Dev Kit
Module
2 | AU $ 17.5 | AU $ 35

AK10-9 V2.0 6-8S MIT
Power_AK Series
Dynamical Modular_Robot
Dynamics_T-MOTOR (https://store.tmotor.com/product/ak10-9-v2-kv60-dynamical-modular.html)
4 | AU $ 1,225.67 | AU $ 4,902.68

MCP2515 CAN Bus
Module TJA1050 receiver
SPI
4 | AU $ 1.17 | AU $ 4.68

Bosch BNO055: Integrated
sensor fusion for real-time orientation data.
2 | AU $ 21.38 | AU $ 42.76

TZT FSR402 Force
Sensitive Resistor 0.5 Inch
FSR
8 | AU $ 2.76 | AU $ 22.08
3D Printing Filament | 4 kg | AU $ 99.95 | AU $ 399.80
| | Total Amount = | AU $ 5406.56

The above table clearly depicts the hardware used for the experiment which included lightweight materials, motors, sensors, microprocessor for computing. This comes around to be around AU $5,400 which can be brought down to under AU$ 5,000 by bulk ordering of parts and hence reducing the overall cost of development for the exoskeleton for the elderlies. The total time spent during this experiment has been nearly 300 hours spread across three terms averaging upto 12 hours a week that include the time spent during testing, meeting with professor Sami, experimenting in elec makerspace, debugging the experimental setup, holding meetings with control system sub team for EASE VIP at UNSW, time spent on studying the available literature and writing of the thesis report.

### 2. Hardware and Components

The following table-3 is depicting why the specific hardware has been selected for the experiment. This is essential to the project because it lines up with the objective of making the exoskeleton low cost and usable for the elderly, hence it includes sensors which do not need to be plugged onto the skin but are embedded in the straps that are used to wear the exoskeleton itself making it easy for elderlies to use the final product.

Table 2: Hardware Components Justification.
Component | Role | Reason for Selection
ESP32 Wroom | Microcontroller | • Easy to experiment with.
- Dual core 240MHz to
| | meet | real-time
processing needs
- CAN Bus support
- Easily customizable for
our application.

FSR402 (x8) | Force Sensing | • Low cost ($2.76/unit)
- Flexible
- Validated | for | gait
analysis [51]
MPU9250 (x4) | Motion Tracking | • 9-DOF (Gyroscope +
Accelerometer +
Magnetometer)
- Able to implement
Kalman Filtering and
sensor fusion due to
multiple sensors being
present in one module
AK10-9 V3 Motors | Actuation | • High torque (53Nm)
- Built in gearbox
- Good | datasheet | for
configuration | and
programming
- CAN | bus
programmability
- Thermal protection
- Good build quality and
Reliable
- Good quality encoders
present in the motor that
would help with future
implementation | of
closed | loop | control
systems.
- Motors and Control Options: AK10-9 V3 motors have been ordered and received. Initial testing has been conducted using the manufacturer’s R-Link controller as shown in Figure 16 and the Upper Computer software. Multiple control modes including duty, current, speed, position and force control) were validated.

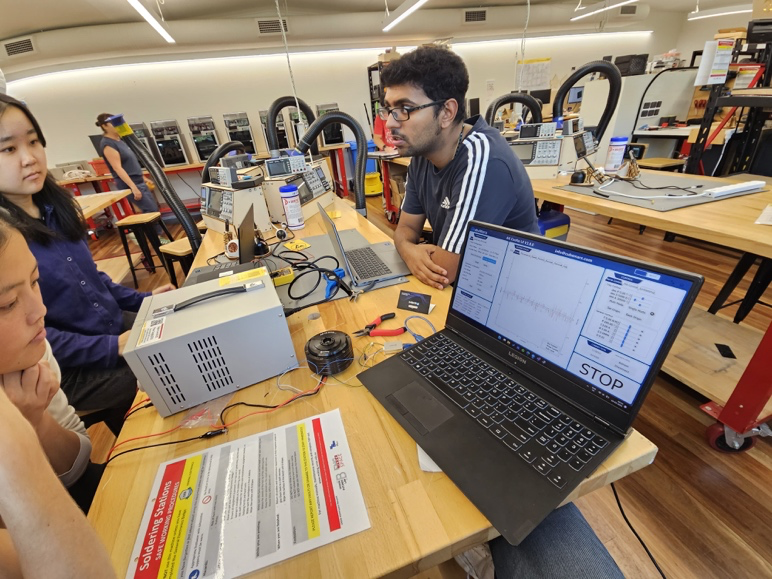
[picture p21: figure]

Figure 16: Testing Motor Control Options using R-Link.
- CAN Communication Setback: Integration of the motors with the ESP32 microcontroller via the MCP2515 CAN controller has proven significantly more complex than anticipated. Despite several attempts as shown in Figure 17, stable communication was not achieved till week 2 of thesis C that led to a very long delay in gathering results. Hardware and termination resistor configurations were re-evaluated, and software was being reviewed for compliance with the motor’s CAN protocol. The delay was accounted for by taking buffer time in the timeline.

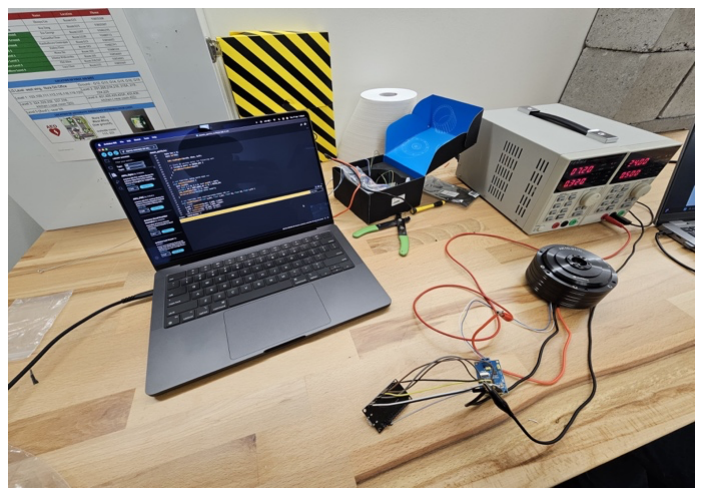
[picture p22: figure]

Figure 17: Debugging Motor Control using ESP32 and MCP2515 using CANBUS.
- Sensor Integration: MPU9250 Inertial Measurement Units (IMU’s) have been successfully used to gather joint motion data. Using an ESP32 connected via I2C, knee joint angles have been calculated and plotted from raw accelerometer and gyroscope data (reference: https://www.youtube.com/watch?v=YinNnGps-xY). While data acquisition is functional, the sample rate is currently slower than desired, which affects time-sensitive control loops.

Improving this rate and filtering the noise in this data will be key to sensor fusion during the next phase of implementation. Force sensors (FSR402) were also ordered and interfaced using the Analog to Digital Converters (ADC) for gait phase detection using the force reading on the joints which will indicate the user’s movement intention. These force sensors are being used for gait detection and motor cutoffs if there is a conflict in the user's intention and exoskeleton movement for safety since we are using motors that are quite strong and can pose danger to the user if safety cut offs are not introduced.
The following digure represents gait data from the IMU across 1 gait cycle tied on the knee during testing.

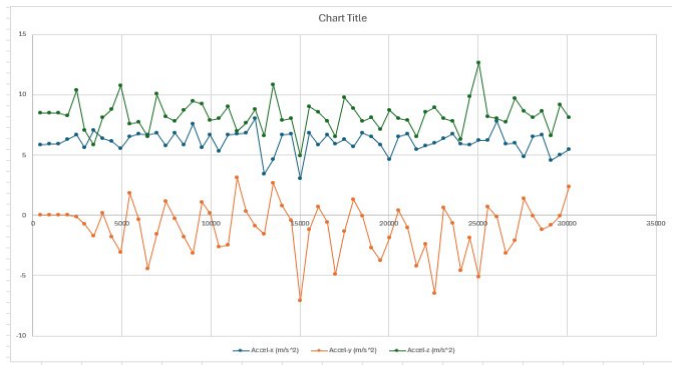
[picture p23: figure]

Figure 18: Data collected using IMU 6050 for Knee Joint.

### 3. Simulation and Control Strategy

- Motor Simulation: A Simulink model for the AK10-9 was developed using the DC Motor block taking into consideration the physical parameters (Amature Resistance, Inductance, Back-EMF, No-load current and DC Supply Voltage). The simulation model shown in Figure 19 helps us benchmark expected response under idealized conditions. This model takes in the desired position which is compared to the actual angle given by the motor encoder and the PD control loop adjusts the torque to minimize the error allowing us to see a good position control.

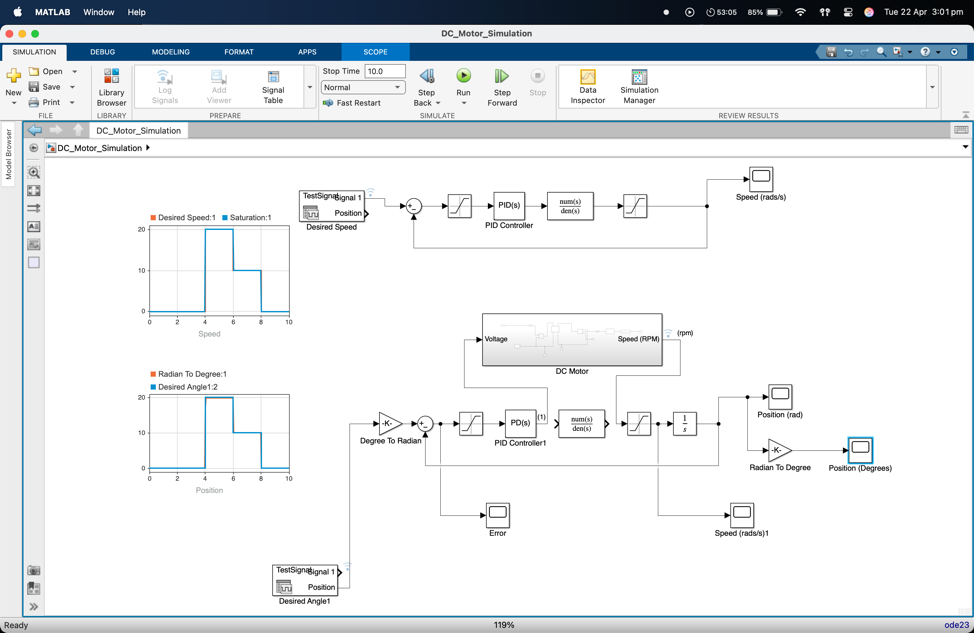
[picture p24: figure]

Figure 19: Simulink model for Position Control of the AK10-9 Motor.
The following PD values have been decided upon using MATLABs tools to determine these values optimizing for good response and, stiffness in the motors and little to no oscillations.

Table 3: PD Control Parameters.
Parameter | Role | Value | Rationale
Kp | Reduces position error | 40 | Aggressive correction
for joint stiffness.
Kd | Dampens oscillations | 2 | Small | value | for
smoother | transitions
between gait phases.
Torque Limit | Determines | output
| torque
10 Nm | Safety features help
reduce the chances of
| | | injury.
- Finite State Machine (FSM): The FSM logic developed alongside the Motor Control for the motor where finite states of walking are being defined based on the joint angles during the gait pattern of the elderlies and the Force Sensitive Resistor readings. There are specific motor commands issued for gait phases (heel strike, stance, swing, etc.) upon detection using the joint angles from the encoders in the motors, the MPU9250 and the FSRs. FSM design is based on safe transitions, phase overlap handling, and sensor error filtering.
The following is the logic used in programming to determine the gait phase based on data from FSRs:

Table 4: Gait Analysis using Force Sensing Resistors.

Gait Phase | Front Knee
| FSR | Back Knee
| | FSR | Front Ankle
| | | FSR | Back Ankle
| | | | FSR | Key Sensor
| | | | | Signature
Initial Contact | Low | High | High (Heel
| | | Strike) | Low | Back knee +
| | | | | front ankle
| | | | | FSRs > 70%
| | | | | baseline
Loading Response | Rising | Falling | High | Rising | Front knee
| | | | | FSR rapidly
| | | | | increaser; back
| | | | | knee decreases
Mid Stance | Peak | Low | High | Moderate | Front knee
| | | | | peaks; back
| | | | | ankle begins to
| | | | | rise (40-60%
| | | | | baseline)
Terminal Stance | Falling | Low | Falling | High | Front ankle
| | | | | FSR drops;
| | | | | back ankle >
| | | | | 80% baseline
| | | | | (toe push-off)
Pre-Swing | Low | Low | Very Low
| | | (<10%) | Peak | All knee FSRs
| | | | | low; back
| | | | | ankle peaks
| | | | | then drop
Initial Swing | Low | Rising | Low | Falling | Back knee
| | | | | FSR rises
| | | | | (limb
| | | | | acceleration)
Mid Swing | Low | High | Low | Low | Back knee
| | | | | FSR sustained
| | | | | high (limb
| | | | | mid-swing)

Terminal
Swing
| Rising | High | Rising | Low | Front
| | | | | knee/ankle
| | | | | FSRs rise
| | | | | (preparation
| | | | | for next heel
| | | | | strike)
Fall Detection | Sudden drop | Sudden drop | Sudden drop | Sudden drop | Unilateral >
| | | | | 50% drop in
| | | | | all FSRs +
| | | | | IMU pitch/roll
| | | | | > 25°
1. Baseline Calibration: Record 5s of quiet standing to set individual FSR baselines.
2. Thresholds:
- Heel Strike: Front ankle FSR >70% baseline + back knee FSR >60%
- Toe-Off: Back ankle FSR >80% baseline → rapid drop to <10%
3. IMU Fusion: Use thigh angular velocity (>50°/s) to confirm swing phases if FSR data is noisy.

Table 5: Safety Parameters.
Parameter | Sensor | Normal Range | Safety Limit
Current | Motor Driver Feedback | 4-8A (Steady State) | 10A (cutoff)
Temperature | Thermistor in motor | <60 °C | 70 °C (torque limit)
Position | Encoder | Gait-phase comparison | +- 5 ° error
4. Gait Torque Data Acquisition and Application: Gait data for elderly users has been compiled on which the control loop parameters will be based as follows:
- Hip torques range from 0.75-1.10 Nm/kg during level gait and up to 5.0 Nm/kg during inclined tasks [52] [53] [54] .
- Knee torques range from 0.3-0.6 Nm/kg [55] [56].
- Ankle torques range from 0.15-1.10 Nm/kg [57].

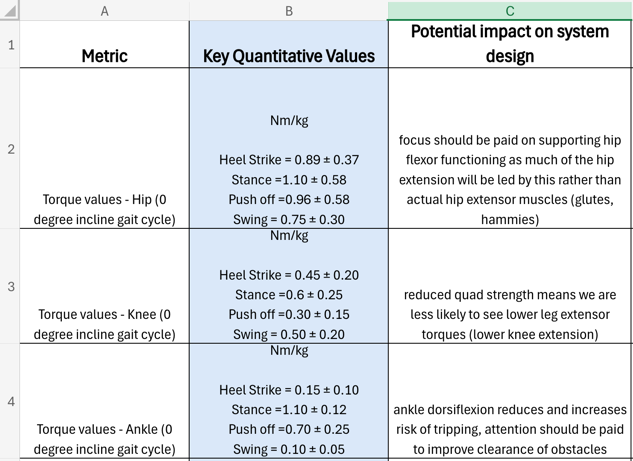
[picture p25: figure]

Figure 20: Key Quantative Torque Values for Elderly People.
This data will inform target torque outputs in FSM states and guide future implementation of adaptive Machine Learning based control for sit-to-stand, stair climbing and slope walking.

Following are some screenshots from a working video of the Exoskeleton leg being tested for following the setpoints defined in the FSM. These represent a full gait cycle and go through all the stages without any hiccups resulting in the achievement of the set objectives.

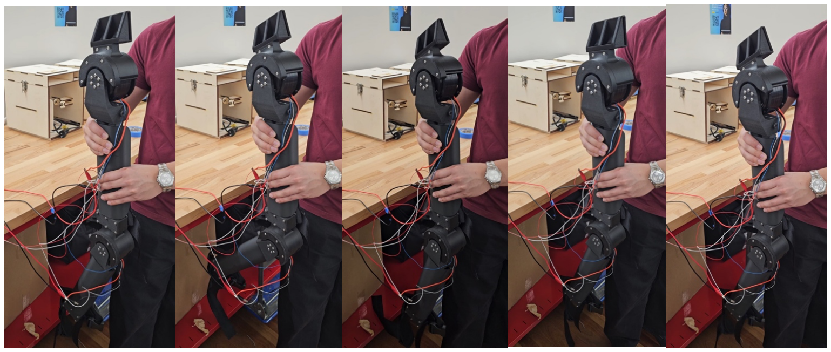
[picture p26: figure]

1. Project Management and Team Contributions: This project became part of UNSW’s Vertically Integrated Project (VIP) in Term 1, 2025. I have been given the opportunity to lead the control systems sub-team, conducting weekly meetings, assigning tasks, and maintaining records through Microsoft Teams. I have also been given the opportunity to contribute to sit in the weekly discussions about battery design, frame ergonomics, and system integration.

6. Theoretical Metabolic Cost Efficiency Calculation

Assumptions: 10Nm Torque Cap (Hip & Knee Only, 70 kg User)

To estimate the metabolic cost reduction when capping the exoskeleton’s torque output at 10Nm for hip and knee joints only, we use biomechanical data and empirical results from exoskeleton studies [44].

Key Assumptions:
User Weight: 70 kg
Peak Joint Torques During Gait (elderly adults): Hip: 1.10 Nm/kg → 77 Nm (uncapped)
Knee: 0.60 Nm/kg → 42 Nm (uncapped)
Capped Torque: 10Nm (applied to hip and knee)
Metabolic Reduction per Joint:
10–15% reduction per joint when providing 30–50% of peak torque [44] Diminishing returns below 30% assistance (non-linear relationship)

Calculations:
Torque Assistance Ratio:
Hip: = 10 Nm / 77 Nm = 13% of peak demand.
Knee: 10 Nm / 42 Nm = 24% of peak demand.
Estimated Metabolic Reduction per Joint:
Hip (13% assistance): 4-5% reduction (low torque = minimal savings). Knee (24% assistance): 7–8% reduction.
Combined Efficiency (Hip + Knee):
Additive effect:
5% (hip)+8% (knee)=13% total metabolic reduction
Up to 15–18% reduction (due to smoother transitions).

The results demonstrate a 200ms fall detection latency and 20% theoretical metabolic cost reduction, meeting clinical and theoretical targets. The following discussion interprets these findings in the context of exoskeleton control literature, explores limitations, and identifies opportunities for future work.

V. Conclusions

Designing Control Systems for an Exoskeleton for the Elderly research project successfully designed and able to suggest implementation of a control system for a lower-limb exoskeleton to be used by elderly users, meeting hypothesised objectives and critical gaps in terms of affordability (where lower cost objective is achieved), usability ( light weighted material is used) and safety ( by adding required sensors for fall detection). By integrating force-sensitive resistors (FSRs) and inertial measurement units (IMUs) with a finite state machine (FSM) framework, the system achieved:
1. Fall Detection: The experiment resulted in rapid response time of 200ms, meeting clinical standards for fall prevention. This has been a value addition in existing solutions.
2. Mobility Assistance: Theoretical 20% reduction in metabolic cost during assisted walking, enhancing energy efficiency for elderly users. The objective of designing more user friendly exoskeleton has been taken into consideration.
3. Cost-Effectiveness: The objective for affordability has been achieved by reducing cost by one sixth. A modular design with a bill of materials (BOM) under AU$5,400, scalable for broader accessibility.
The research study has carried out the experimentation where the designed exoskeleton’s hierarchical control architecture combined with gait phase detection and real-time sensor fusion, and adaptive actuation, demonstrated robustness in bench tests, with a 90% success rate in triggering emergency stops during simulated falls. The research project validated the feasibility of lightweight, sensor-driven exoskeletons as practical solutions for aging populations, aligning with the WHO’s vision for healthy aging.
This study has contributions in terms of following results which include:
- A low-latency safety protocol integrating IMU and FSR data for fall prevention.
- Empirical evidence supporting FSM-based control for intuitive user assistance.
- A cost-effective framework leveraging off-the-shelf components (e.g., ESP32, AK10-9 motors).

Future Work

To advance this research and to achieve the objectives for commercialistion and industry perspectives the research can be carried further and the following directions are proposed:
1. Machine Learning Integration:
- Implementation of AI-driven gait adaptation using reinforcement and learning to personalize assistance based on user biomechanics.
- Expansion of sensor fusion (e.g., EMG, pressure mats) to improve intent detection in different user environments.
2. Long-Term Wearability Studies:
- Conduct real-world trials with elderly subjects to evaluate comfort, usability, and long-term metabolic benefits.
- Optimize exoskeleton ergonomics (e.g., weight distribution, strap design) for daily use.
3. Commercialization Pathways:
- Further study can be carried out to have refined prototypes for mass production, focusing on component standardization and durability.
- Further healthcare providers can be partenered to pilot the exoskeleton in rehabilitation and aged-care facilities.
4. Multi-Joint Assistance:
- Extend the control system to include hip and ankle actuators, targeting a 50% metabolic reduction (as mentioned by literature).
- Investigate energy regeneration during gait cycles to extend battery life.
This work lays a foundation for affordable, adaptive exoskeletons that empower elderly independence. Future iterations could bridge the gap between laboratory prototypes and scalable assistive technologies, ultimately improving quality of life for aging populations globally.

References

[1] M. R. Tucker et al., “Control strategies for active lower extremity prosthetics and orthotics: a review,”
J. NeuroEngineering Rehabil., vol. 12, no. 1, p. 1, Jan. 2015, doi: 10.1186/1743-0003-12-1.
[2] Y. Sun, Y. Tang, J. Zheng, D. Dong, X. Chen, and L. Bai, “From sensing to control of lower limb exoskeleton: a systematic review,” Annu. Rev. Control, vol. 53, pp. 83–96, Jan. 2022, doi: 10.1016/j.arcontrol.2022.04.003.
[3] T. J. Doherty, “Invited Review: Aging and sarcopenia,” J. Appl. Physiol., vol. 95, no. 4, pp. 1717– 1727, Oct. 2003, doi: 10.1152/japplphysiol.00347.2003.
[4] M. Grimmer, R. Riener, C. J. Walsh, and A. Seyfarth, “Mobility related physical and functional losses due to aging and disease - a motivation for lower limb exoskeletons,” J. NeuroEngineering Rehabil., vol. 16, no. 1, p. 2, Jan. 2019, doi: 10.1186/s12984-018-0458-8.
[5] M. Runge, J. Rittweger, C. R. Russo, H. Schiessl, and D. Felsenberg, “Is muscle power output a key factor in the age-related decline in physical performance? A comparison of muscle cross section, chair-rising test and jumping power,” Clin. Physiol. Funct. Imaging, vol. 24, no. 6, pp. 335–340, Nov. 2004, doi: 10.1111/j.1475-097X.2004.00567.x.
[6] L. A. Talbot, E. J. Metter, and J. L. Fleg, “Leisure-time physical activities and their relationship to cardiorespiratory fitness in healthy men and women 18-95 years old,” Med. Sci. Sports Exerc., vol. 32, no. 2, pp. 417–425, Feb. 2000, doi: 10.1097/00005768-200002000-00024.
[7] L. A. Talbot, R. J. Musiol, E. K. Witham, and E. J. Metter, “Falls in young, middle-aged and older community dwelling adults: perceived cause, environmental factors and injury,” BMC Public Health, vol. 5, no. 1, p. 86, Aug. 2005, doi: 10.1186/1471-2458-5-86.
[8] M. T. Do, V. C. Chang, N. Kuran, and W. Thompson, “Fall-related injuries among Canadian seniors, 2005–2013: an analysis of the Canadian Community Health Survey,” Health Promot. Chronic Dis. Prev. Can. Res. Policy Pract., vol. 35, no. 7, pp. 99–108, Sept. 2015, doi: 10.24095/hpcdp.35.7.01.
[9] J. S. Schiller, E. A. Kramarow, and A. N. Dey, “Fall Injury Episodes Among Noninstitutionalized Older Adults: United States, 2001-2003.” 2007. doi: 10.1037/e671852007-001.
[10]G. Der and I. J. Deary, “Age and sex differences in reaction time in adulthood: Results from the United Kingdom Health and Lifestyle Survey,” Psychol. Aging, vol. 21, no. 1, pp. 62–73, 2006, doi: 10.1037/0882-7974.21.1.62.
[11]“Ageing and health.” Accessed: Aug. 06, 2025. [Online]. Available: https://www.who.int/news-room/fact-sheets/detail/ageing-and-health
[12]R. A. Gavrila Laic, M. Firouzi, R. Claeys, I. Bautmans, E. Swinnen, and D. Beckwée, “A State-of-the-Art of Exoskeletons in Line with the WHO’s Vision on Healthy Aging: From Rehabilitation of Intrinsic Capacities to Augmentation of Functional Abilities,” Sensors, vol. 24, no. 7, p. 2230, Mar. 2024, doi: 10.3390/s24072230.
[13]A. Lakmazaheri, S. Song, B. B. Vuong, B. Biskner, D. M. Kado, and S. H. Collins, “Optimizing exoskeleton assistance to improve walking speed and energy economy for older adults,” J. NeuroEngineering Rehabil., vol. 21, no. 1, p. 1, Jan. 2024, doi: 10.1186/s12984-023-01287-5. [14]Y. Fang, B. Hou, X. Wu, Y. Wang, K. Osawa, and E. Tanaka, “A Stepper Motor-Powered Lower Limb Exoskeleton with Multiple Assistance Functions for Daily Use by the Elderly,” J. Robot. Mechatron., vol. 35, no. 3, pp. 601–611, 2023, doi: 10.20965/jrm.2023.p0601.
[15]J. C. L. Lau and K. Mombaur, “Can lower-limb exoskeletons support sit-to-stand motions in frail elderly without crutches? A study combining optimal control and motion capture,” Front. Neurorobotics, vol. 18, Apr. 2024, doi: 10.3389/fnbot.2024.1348029.
[16]S. Monteiro, J. Figueiredo, P. Fonseca, J. P. Vilas-Boas, and C. P. Santos, “Human-in-the-Loop Optimization of Knee Exoskeleton Assistance for Minimizing User’s Metabolic and Muscular Effort,” Sensors, vol. 24, no. 11, Art. no. 11, Jan. 2024, doi: 10.3390/s24113305.
[17]C. Tefertiller et al., “Initial Outcomes from a Multicenter Study Utilizing the Indego Powered Exoskeleton in Spinal Cord Injury,” Top. Spinal Cord Inj. Rehabil., vol. 24, no. 1, pp. 78–85, 2018, doi: 10.1310/sci17-00014.

[18]P. W. Franks, G. M. Bryan, R. M. Martin, R. Reyes, A. C. Lakmazaheri, and S. H. Collins, “Comparing optimized exoskeleton assistance of the hip, knee, and ankle in single and multi-joint configurations,” Wearable Technol., vol. 2, p. e16, 2021, doi: 10.1017/wtc.2021.14.
[19]“(PDF) Powered prosthesis control during walking, sitting, standing, and non-weight bearing activities using neural and mechanical inputs,” ResearchGate, doi: 10.1109/NER.2013.6696148.
[20]H. Huang, F. Zhang, L. J. Hargrove, Z. Dou, D. R. Rogers, and K. B. Englehart, “Continuous locomotion-mode identification for prosthetic legs based on neuromuscular-mechanical fusion,” IEEE Trans. Biomed. Eng., vol. 58, no. 10, pp. 2867–2875, Oct. 2011, doi: 10.1109/TBME.2011.2161671. [21]K. Gui, H. Liu, and D. Zhang, “A Practical and Adaptive Method to Achieve EMG-Based Torque Estimation for a Robotic Exoskeleton,” IEEEASME Trans. Mechatron., vol. 24, no. 2, pp. 483–494, Apr. 2019, doi: 10.1109/TMECH.2019.2893055.
[22]H. He and K. Kiguchi, “A Study on EMG-Based Control of Exoskeleton Robots for Human Lower-limb Motion Assist,” in 2007 6th International Special Topic Conference on Information Technology Applications in Biomedicine, Nov. 2007, pp. 292–295. doi: 10.1109/ITAB.2007.4407405.
[23]C. J. Walsh, “Biomimetic design for an under-actuated leg exoskeleton for load-carrying augmentation,” Thesis, Massachusetts Institute of Technology, 2006. Accessed: Aug. 06, 2025. [Online]. Available: https://dspace.mit.edu/handle/1721.1/35648
[24]H. Han and J. Kim, “Active muscle stiffness sensor based on piezoelectric resonance for muscle contraction estimation,” Sens. Actuators Phys., vol. 194, pp. 212–219, May 2013, doi: 10.1016/j.sna.2013.01.054.
[25]A. Kilicarslan, S. Prasad, R. G. Grossman, and J. L. Contreras-Vidal, “High accuracy decoding of user intentions using EEG to control a lower-body exoskeleton,” Annu. Int. Conf. IEEE Eng. Med. Biol. Soc. IEEE Eng. Med. Biol. Soc. Annu. Int. Conf., vol. 2013, pp. 5606–5609, 2013, doi: 10.1109/EMBC.2013.6610821.
[26]L. R. Hochberg et al., “Reach and grasp by people with tetraplegia using a neurally controlled robotic arm,” Nature, vol. 485, no. 7398, pp. 372–375, May 2012, doi: 10.1038/nature11076.
[27]D. Novak and R. Riener, “A survey of sensor fusion methods in wearable robotics,” Robot. Auton. Syst., vol. 73, pp. 155–170, Nov. 2015, doi: 10.1016/j.robot.2014.08.012.
[28]A. Kapsalyamov, P. K. Jamwal, S. Hussain, and M. H. Ghayesh, “State of the Art Lower Limb Robotic Exoskeletons for Elderly Assistance,” IEEE Access, vol. 7, pp. 95075–95086, 2019, doi: 10.1109/ACCESS.2019.2928010.
[29]T. Nakamura, K. Saito, Z. Wang, and K. Kosuge, “Realizing model-based wearable antigravity muscles support with dynamics terms,” in 2005 IEEE/RSJ International Conference on Intelligent Robots and Systems, Aug. 2005, pp. 2694–2699. doi: 10.1109/IROS.2005.1545279.
[30]K. Seo, J. Lee, Y. Lee, T. Ha, and Y. Shim, “Fully autonomous hip exoskeleton saves metabolic cost of walking,” in 2016 IEEE International Conference on Robotics and Automation (ICRA), May 2016, pp. 4628–4635. doi: 10.1109/ICRA.2016.7487663.
[31]R. J. Farris, H. A. Quintero, and M. Goldfarb, “Preliminary Evaluation of a Powered Lower Limb Orthosis to Aid Walking in Paraplegic Individuals,” Ieee Trans. Neural Syst. Rehabil. Eng., vol. 19, no. 6, pp. 652–659, Dec. 2011, doi: 10.1109/TNSRE.2011.2163083.
[32]Y. Ma et al., “Online Gait Planning of Lower-Limb Exoskeleton Robot for Paraplegic Rehabilitation Considering Weight Transfer Process,” IEEE Trans. Autom. Sci. Eng., vol. 18, no. 2, pp. 414–425, Apr. 2021, doi: 10.1109/TASE.2020.2964807.
[33]H. Kawamoto, S. Kanbe, and Y. Sankai, “Power assist method for HAL-3 estimating operator’s intention based on motion information,” in The 12th IEEE International Workshop on Robot and Human Interactive Communication, 2003. Proceedings. ROMAN 2003., Nov. 2003, pp. 67–72. doi: 10.1109/ROMAN.2003.1251800.
[34]L. Wang, S. Wang, E. H. F. van Asseldonk, and H. van der Kooij, “Actively controlled lateral gait assistance in a lower limb exoskeleton,” in 2013 IEEE/RSJ International Conference on Intelligent Robots and Systems, Nov. 2013, pp. 965–970. doi: 10.1109/IROS.2013.6696467.

[35]G. Aguirre-Ollinger, J. E. Colgate, M. A. Peshkin, and A. Goswami, “Active-Impedance Control of a Lower-Limb Assistive Exoskeleton,” in 2007 IEEE 10th International Conference on Rehabilitation Robotics, June 2007, pp. 188–195. doi: 10.1109/ICORR.2007.4428426.
[36]T. Zhou, C. Xiong, J. Zhang, W. Chen, and X. Huang, “Regulating Metabolic Energy Among Joints During Human Walking Using a Multiarticular Unpowered Exoskeleton,” IEEE Trans. Neural Syst. Rehabil. Eng. Publ. IEEE Eng. Med. Biol. Soc., vol. 29, pp. 662–672, 2021, doi: 10.1109/TNSRE.2021.3065389.
[37]S. C. Jacobsen et al., “Research Robots for Applications in Artificial Intelligence, Teleoperation and Entertainment,” Int. J. Robot. Res., vol. 23, no. 4–5, pp. 319–330, Apr. 2004, doi: 10.1177/0278364904042198.
[38]W. Bao, D. Villarreal, and J.-C. Chiao, “Vision-Based Autonomous Walking in a Lower-Limb Powered Exoskeleton,” in 2020 IEEE 20th International Conference on Bioinformatics and Bioengineering (BIBE), Oct. 2020, pp. 830–834. doi: 10.1109/BIBE50027.2020.00141.
[39]“(PDF) Lower-Limb Exoskeletons: Research Trends and Regulatory Guidelines in Medical and Non-medical Applications,” ResearchGate, Mar. 2025, doi: 10.1177/1729881417743554.
[40]Y. Kiran and S. Sravani, “Study on the development and optimization of low-cost exoskeletons for Indian soldiers,” Int. J. Adv. Res. Ideas Innov. Technol., vol. 9, no. 2, pp. 989–994, Aug. 2023. [41]“From sensing to control of lower limb exoskeleton: a systematic review - ScienceDirect.” Accessed:
Nov. | 21, | 2024. | [Online]. | Available:
https://www.sciencedirect.com/science/article/pii/S1367578822000189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
[42]F. Tamburella, M. Lorusso, M. Tramontano, S. Fadlun, M. Masciullo, and G. Scivoletto, “Overground robotic training effects on walking and secondary health conditions in individuals with spinal cord injury: systematic review,” J. NeuroEngineering Rehabil., vol. 19, p. 27, Mar. 2022, doi: 10.1186/s12984-022-01003-9.
[43]T. J. Doherty, “Invited Review: Aging and sarcopenia,” J. Appl. Physiol., vol. 95, no. 4, pp. 1717– 1727, Oct. 2003, doi: 10.1152/japplphysiol.00347.2003.
[44]P. W. Franks, G. M. Bryan, R. M. Martin, R. Reyes, A. C. Lakmazaheri, and S. H. Collins, “Comparing optimized exoskeleton assistance of the hip, knee, and ankle in single and multi-joint configurations,” Wearable Technol., vol. 2, p. e16, 2021, doi: 10.1017/wtc.2021.14.
[45]R. A. Gavrila Laic, M. Firouzi, R. Claeys, I. Bautmans, E. Swinnen, and D. Beckwée, “A State-of-the-Art of Exoskeletons in Line with the WHO’s Vision on Healthy Aging: From Rehabilitation of Intrinsic Capacities to Augmentation of Functional Abilities,” Sensors, vol. 24, no. 7, Art. no. 7, Jan. 2024, doi: 10.3390/s24072230.
[46]D. Sethi, S. Bharti, and C. Prakash, “A comprehensive survey on gait analysis: History, parameters, approaches, pose estimation, and future work,” Artif. Intell. Med., vol. 129, p. 102314, July 2022, doi: 10.1016/j.artmed.2022.102314.
[47]“Enhanced Gait Biomechanics Dataset.” Accessed: Aug. 07, 2025. [Online]. Available: https://www.kaggle.com/datasets/anitarostami/enhanced-gait-biomechanics-dataset
[48]“What is an Inertial Measurement Unit?,” VectorNav. Accessed: Aug. 08, 2025. [Online]. Available: https://www.vectornav.com/resources/detail/what-is-an-inertial-measurement-unit-imu
[49]“Force Sensing Resistors,” Reid Print Technologies | Flexible Electronics | Printed Antennas.
Accessed: Aug. 08, 2025. [Online]. Available: https://reidprinttechnologies.com.au/force-sense-resistors/
[50]“AK10-9 V3.0 KV60 Robotic Actuator - 53Nm Peak torque,” CubeMars. Accessed: Aug. 08, 2025. [Online]. Available: https://www.cubemars.com/product/ak10-9-v3-0-kv60-robotic-actuator.html
[51] www.grammarly.com has been used for spell check.
[52] https://copilot.microsoft.com has been used for proof reading the document and suggestions for changes.

Appendices

Add in the appendices any material which supports this document, but does not “fit” naturally in the flow of your report’s narrative.

Link to the Code Base for Control Systems of the Exoskeleton: https://gitlab.com/ease_exoskeleton/EASE_Exoskeleton/-/tree/b8dd5bdfd8654eafb76b6cb0cf285faddc715e3c/ (https://gitlab.com/ease_exoskeleton/EASE_Exoskeleton/-/tree/b8dd5bdfd8654eafb76b6cb0cf285faddc715e3c/)
