Tanmeetsingh24/control-systems-for-exoskeleton/docs/images/ease-screenshot.png

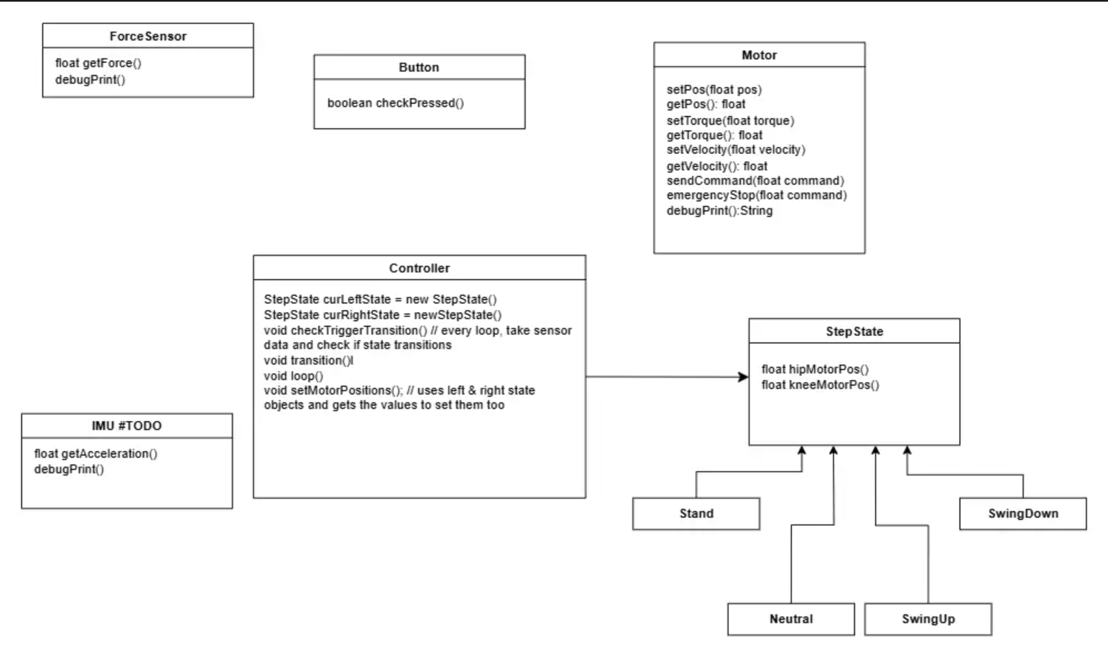
docs/images/ease-screenshot.png
