Tanmeetsingh24/control-systems-for-exoskeleton/docs/images/hil-screenshot.png

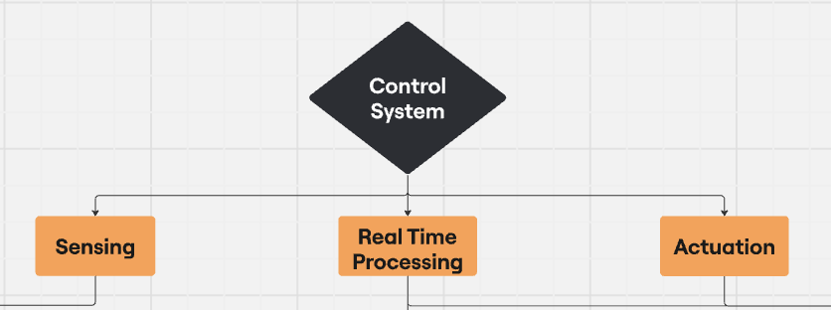
docs/images/hil-screenshot.png
