Tanmeetsingh24/control-systems-for-exoskeleton/firmware/hil-motor-control/MotorControl.ino

#include <SPI.h>
#include <mcp2515.h>
#include <cstdint>
struct can_frame canMsg;
float hipLeftGait[] = { 0.124173751, 0.118893376, 0.113848102, 0.109173964, 0.105117433,
0.102018233, 0.100256832, 0.100186874, 0.102080963, 0.106106823,
0.11232985, 0.120733988, 0.131244553, 0.143739973, 0.158043273,
0.173911082, 0.191038232, 0.209083343, 0.227698099, 0.246550355,
0.265338018, 0.283799304, 0.301721094, 0.318948488, 0.335391974,
0.351023091, 0.365848232, 0.379866243, 0.393034221, 0.405265861,
0.41645958, 0.426528165, 0.43540335, 0.443013095, 0.449250316,
0.453956445, 0.456932749, 0.457979636, 0.456954662, 0.4538404,
0.448814491, 0.442309599, 0.435024735, 0.427844811, 0.421673648,
0.417247725, 0.414994627, 0.414963804, 0.416826652};

float hipRightGait[] = { 0.444408834, 0.446378444, 0.447181602, 0.446534546, 
0.444555754, 0.44167249, 0.438403041, 0.435104709, 0.431803519, 0.428186508, 
0.423750571, 0.418031449, 0.410801834, 0.402159281, 0.392475268, 0.382249264, 
0.371940883, 0.361855035, 0.352108682, 0.342670401, 0.333435109, 0.324296727, 
0.315192117, 0.306114271, 0.29710261, 0.288223599, 0.279548379, 0.271135017, 
0.263022213, 0.25523342, 0.247781926, 0.240668297, 0.233876164, 0.227373995, 
0.221124361, 0.215093483, 0.209257371, 0.203601548, 0.19811274, 0.192762414, 
0.187491954, 0.182216295, 0.176855445, 0.171379818, 0.165841156, 0.160361801, 
0.155083568, 0.150103835, 0.145434597, 0.141005461, 0.1367128, 0.132496006, 
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
int gaitLength = sizeof(hipLeftGait) / sizeof(hipLeftGait[0]);
int gaitIndex = 0;

// Unique motor IDs (replace with actual IDs)
const uint8_t MOTOR_ID_LEFT_HIP = 0x03;
const uint8_t MOTOR_ID_RIGHT_HIP = 0x01;
const uint8_t MOTOR_ID_LEFT_KNEE = 0x04;
const uint8_t MOTOR_ID_RIGHT_KNEE = 0x02;

// Convert float to uint for MIT packet
int float_to_uint(float x, float x_min, float x_max, unsigned int bits) {
  float span = x_max - x_min;
  float offset = x_min;
  if (x < x_min) x = x_min;
  if (x > x_max) x = x_max;
  return (int)((x - offset) * ((float)((1 << bits) - 1) / span));
}

// Send MIT-style motor command
void sendMITCommand(float p_des, float v_des, float kp, float kd, float t_ff, uint8_t motor_id) {
  int p_int  = float_to_uint(p_des, -12.56f, 12.56f, 16);
  int v_int  = float_to_uint(v_des, -33.0f, 33.0f, 12);
  int kp_int = float_to_uint(kp, 0.0f, 500.0f, 12);
  int kd_int = float_to_uint(kd, 0.0f, 5.0f, 12);
  int t_int  = float_to_uint(t_ff, -65.0f, 65.0f, 12);

  uint32_t can_id = (0x08 << 8) | motor_id;
  canMsg.can_id = 0x80000000UL | can_id;
  canMsg.can_dlc = 8;

  canMsg.data[0] = kp_int >> 4;
  canMsg.data[1] = ((kp_int & 0xF) << 4) | (kd_int >> 8);
  canMsg.data[2] = kd_int & 0xFF;
  canMsg.data[3] = p_int >> 8;
  canMsg.data[4] = p_int & 0xFF;
  canMsg.data[5] = v_int >> 4;
  canMsg.data[6] = ((v_int & 0xF) << 4) | (t_int >> 8);
  canMsg.data[7] = t_int & 0xFF;

  mcp2515.sendMessage(&canMsg);
}

void setup() {
  Serial.begin(115200);
  SPI.begin();

  mcp2515.reset();
  mcp2515.setBitrate(CAN_1000KBPS, MCP_8MHZ);
  mcp2515.setNormalMode();
  
  delay(10000);
  Serial.println("Multi-joint gait tracking started");
}

void loop() {
  // Common control params
  float v_des = 0.0;
  float kp = 40.0;
  float kd = 2.0;
  float torque_ff = 0.0;
  
  delay(10);
  // Send commands to all motors
  sendMITCommand(hipLeftGait[gaitIndex],  v_des, kp, kd, torque_ff, MOTOR_ID_LEFT_HIP);
  sendMITCommand(hipRightGait[gaitIndex], v_des, kp, kd, torque_ff, MOTOR_ID_RIGHT_HIP);
  sendMITCommand(kneeLeftGait[gaitIndex], v_des, kp, kd, torque_ff, MOTOR_ID_LEFT_KNEE);
  sendMITCommand(kneeRightGait[gaitIndex],v_des, kp, kd, torque_ff, MOTOR_ID_RIGHT_KNEE);

  gaitIndex = (gaitIndex + 1) % gaitLength;
  delay(20); // ~50 Hz control loop
}
