Tanmeetsingh24/control-systems-for-exoskeleton/firmware/draft/graphGait.py

import numpy as np
import matplotlib.pyplot as plt
from matplotlib.patches import Patch

# 1) RAW JOINT DATA
# hipRightGait is set to its original hardcoded values
hipRightGait = np.array([
    0.444408834, 0.446378444, 0.447181602, 0.446534546, 0.444555754,
    0.44167249, 0.438403041, 0.435104709, 0.431803519, 0.428186508,
    0.423750571, 0.418031449, 0.410801834, 0.402159281, 0.392475268,
    0.382249264, 0.371940883, 0.361855035, 0.352108682, 0.342670401,
    0.333435109, 0.324296727, 0.315192117, 0.306114271, 0.29710261,
    0.288223599, 0.279548379, 0.271135017, 0.263022213, 0.25523342,
    0.247781926, 0.240668297, 0.233876164, 0.227373995, 0.221124361,
    0.215093483, 0.209257371, 0.203601548, 0.19811274, 0.192762414,
    0.187491954, 0.182216295, 0.176855445, 0.171379818, 0.165841156,
    0.160361801, 0.155083568, 0.150103835, 0.145434597, 0.141005461,
    0.1367128, 0.132496006, 0.128411569, 0.124674405, 0.121651278,
    0.119807204, 0.119622431, 0.121501346, 0.125700023, 0.132290417,
    0.14116961, 0.152102437, 0.164782903, 0.178896222, 0.194161315,
    0.210338075, 0.227205111, 0.244534383, 0.262087803, 0.2796385,
    0.296995705, 0.314013691, 0.330585374, 0.346634911, 0.3621156,
    0.377003142, 0.391271264, 0.404852681, 0.417607305, 0.429325209,
    0.439774511, 0.448778056, 0.456278693, 0.462354773, 0.467167722,
    0.470865743, 0.473491195, 0.474939948, 0.474992229, 0.473409571,
    0.470065511, 0.465065706, 0.458813434, 0.451990084, 0.445444401,
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
    0.676836816, 0.641719979, 0.605031643, 0.56711349, 0.528256892,
    0.488737301, 0.448964013, 0.409728228, 0.372412603, 0.338966899,
    0.311556523, 0.292022651, 0.281398498, 0.27963726
])

# 2) NORMALIZE AND EXTEND DATA TO 3 GAIT CYCLES

def smooth_normalize(arr, n_points=200):
    """
    Smooths and normalizes a given array to a specified number of points.
    It also removes the initial value and the linear trend from start to end.
    """
    x_old = np.linspace(0, 1, len(arr))
    x_new = np.linspace(0, 1, n_points)
    resampled = np.interp(x_new, x_old, arr)
    resampled -= resampled[0] # Set the first point to zero
    # Remove linear trend from start to end
    resampled -= np.linspace(0, resampled[-1], n_points)
    return resampled

N = 200 # Number of points per gait cycle
num_cycles = 3 # Number of gait cycles to plot
x_len = N * num_cycles # Total number of points for the plot
phase_percent = np.linspace(0, 100 * num_cycles, x_len) # X-axis for plotting (Gait Cycle %)

# Normalize and phase shift the data
hipL_smooth = smooth_normalize(hipLeftGait, N)
kneeL_smooth = smooth_normalize(kneeLeftGait, N)
hipR_smooth = smooth_normalize(hipRightGait, N)
kneeR_smooth = smooth_normalize(kneeRightGait, N)

# Apply a phase shift to the right leg data to simulate alternating gait
# This shifts the second half of the cycle to the beginning
hipR_smooth = np.concatenate((hipR_smooth[N//2:], hipR_smooth[:N//2]))
kneeR_smooth = np.concatenate((kneeR_smooth[N//2:], kneeR_smooth[:N//2]))

# Repeat the smoothed data for the specified number of gait cycles
hipL_cycle = np.tile(hipL_smooth, num_cycles)
kneeL_cycle = np.tile(kneeL_smooth, num_cycles)
hipR_cycle = np.tile(hipR_smooth, num_cycles)
kneeR_cycle = np.tile(kneeR_smooth, num_cycles)

# 3) PLOT

plt.figure(figsize=(16, 9)) # Set the figure size for better visualization
ax = plt.gca() # Get the current axes

# Define subphases of gait for background shading
gait_subphases = [
    {"name": "Initial Contact (IC)", "start": 0, "end": 2, "color": "#CCE5FF"}, # Light Blue
    {"name": "Loading Response (LR)", "start": 2, "end": 12, "color": "#B3D9FF"}, # Medium Blue
    {"name": "Mid Stance (MSt)", "start": 12, "end": 31, "color": "#99CCFF"}, # Blue
    {"name": "Terminal Stance (TSt)", "start": 31, "end": 50, "color": "#80BFFF"}, # Darker Blue
    {"name": "Pre-Swing (PSw)", "start": 50, "end": 62, "color": "#FFCCB3"}, # Light Orange
    {"name": "Initial Swing (ISw)", "start": 62, "end": 75, "color": "#FFB380"}, # Medium Orange
    {"name": "Mid Swing (MSw)", "start": 75, "end": 87, "color": "#FF994D"}, # Orange
    {"name": "Terminal Swing (TSw)", "start": 87, "end": 100, "color": "#FF8000"} # Dark Orange
]

# Plot background subphases for each gait cycle
phase_patches = [] # To store legend patches for subphases
for cycle in range(num_cycles):
    offset = cycle * 100 # Offset for each subsequent cycle
    for phase in gait_subphases:
        start = phase["start"] + offset
        end = phase["end"] + offset
        ax.axvspan(start, end, color=phase["color"], alpha=0.5) # Add shaded region
        if cycle == 0: # Only add patches for the first cycle to the legend
            phase_patches.append(Patch(facecolor=phase["color"], label=phase["name"] + " (Left Leg)"))

# Plot joint angles for hip and knee, left and right
plt.plot(phase_percent, hipL_cycle, label="Hip Left", color='blue', linewidth=2)
plt.plot(phase_percent, hipR_cycle, label="Hip Right (Phase Shifted)", color='red', linewidth=2)
plt.plot(phase_percent, kneeL_cycle, label="Knee Left", color='green', linewidth=2)
plt.plot(phase_percent, kneeR_cycle, label="Knee Right (Phase Shifted)", color='orange', linewidth=2)

# Add a horizontal line at y=0 for reference
plt.axhline(0, color='black', linestyle='--', alpha=0.5)

# Define gait event markers
gait_event_lines = [
    ("Initial Contact (IC)", 0),
    ("Loading Response Ends", 2),
    ("Mid Stance Ends", 12),
    ("Terminal Stance Ends", 31),
    ("Toe Off (TO)", 50),
    ("Initial Swing Ends", 62),
    ("Mid Swing Ends", 75),
    ("Terminal Swing Ends", 87)
]

# Plot vertical lines and text labels for gait events
y_text_pos = plt.ylim()[1] * 0.95 # Position for text labels
for cycle in range(num_cycles):
    offset = cycle * 100
    for label, percent in gait_event_lines:
        x = percent + offset
        plt.axvline(x, color='gray', linestyle=':', linewidth=1.5, alpha=0.7) # Vertical line
        if cycle == 0: # Only add text labels for the first cycle
            plt.text(x + 1, y_text_pos, label, rotation=90, verticalalignment='top', fontsize=8, color='dimgray')

# Set plot labels and title
plt.xlabel("Gait Cycle (%)")
plt.ylabel("Joint Angle (radians)")
plt.title("Smoothed Gait Data Over 3 Gait Cycles with Subphases (Left Leg Reference)")
plt.grid(True) # Add grid

# Create a custom legend combining plot lines and phase patches
handles, labels = ax.get_legend_handles_labels()
# Filter out handles/labels that are not the main plot lines
plot_handles = [h for h, l in zip(handles, labels) if l in ["Hip Left", "Hip Right (Phase Shifted)", "Knee Left", "Knee Right (Phase Shifted)"]]
plot_labels = ["Hip Left", "Hip Right (Phase Shifted)", "Knee Left", "Knee Right (Phase Shifted)"]

# Combine plot handles/labels with phase patches for the final legend
plt.legend(handles=plot_handles + phase_patches, labels=plot_labels + [p["name"] for p in gait_subphases],
           loc='upper left', bbox_to_anchor=(1.02, 1), ncol=1, fontsize=9) # Position legend outside plot

plt.tight_layout(rect=[0, 0, 0.78, 1]) # Adjust layout to prevent legend overlap
plt.savefig("gait_3_cycles.png") # Save the plot as a PNG image
plt.show()
