Tanmeetsingh24/control-systems-for-exoskeleton/(commit log)

2026-09-17 Add graduate thesis control systems code, simulations, and docs.
    Curated snapshot of EASE exoskeleton gait FSM firmware, ESP32-S3 HIL
    scaffold, MATLAB/Simulink models, and thesis figures on the thesis branch.
2026-09-19 Add portfolio case-study section to README.
2026-09-19 Polish case-study README wording: Lesson heading, punctuation, and context.
